tylerreckart/lorentz/images/LORENTZ_REV-A_black.png

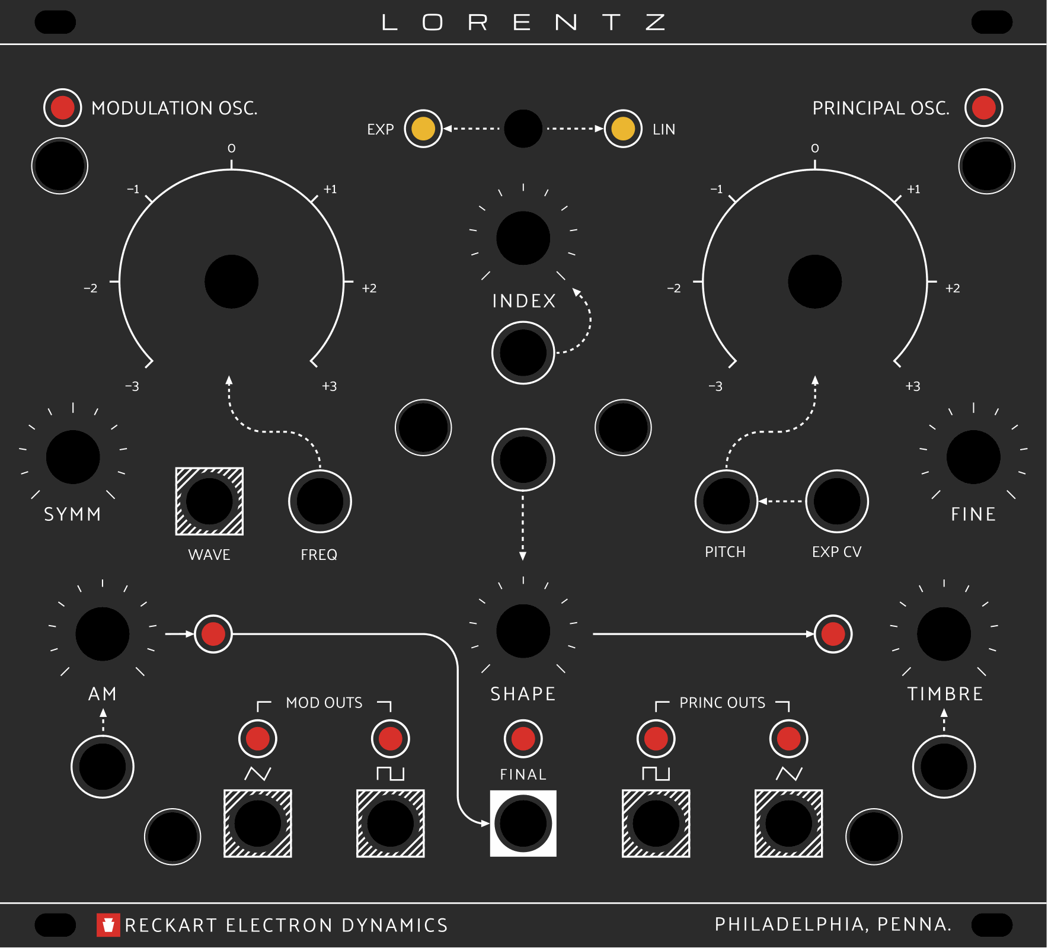
images/LORENTZ_REV-A_black.png
