tylerreckart/lorentz/images/LORENTZ_REV-A_panels.png

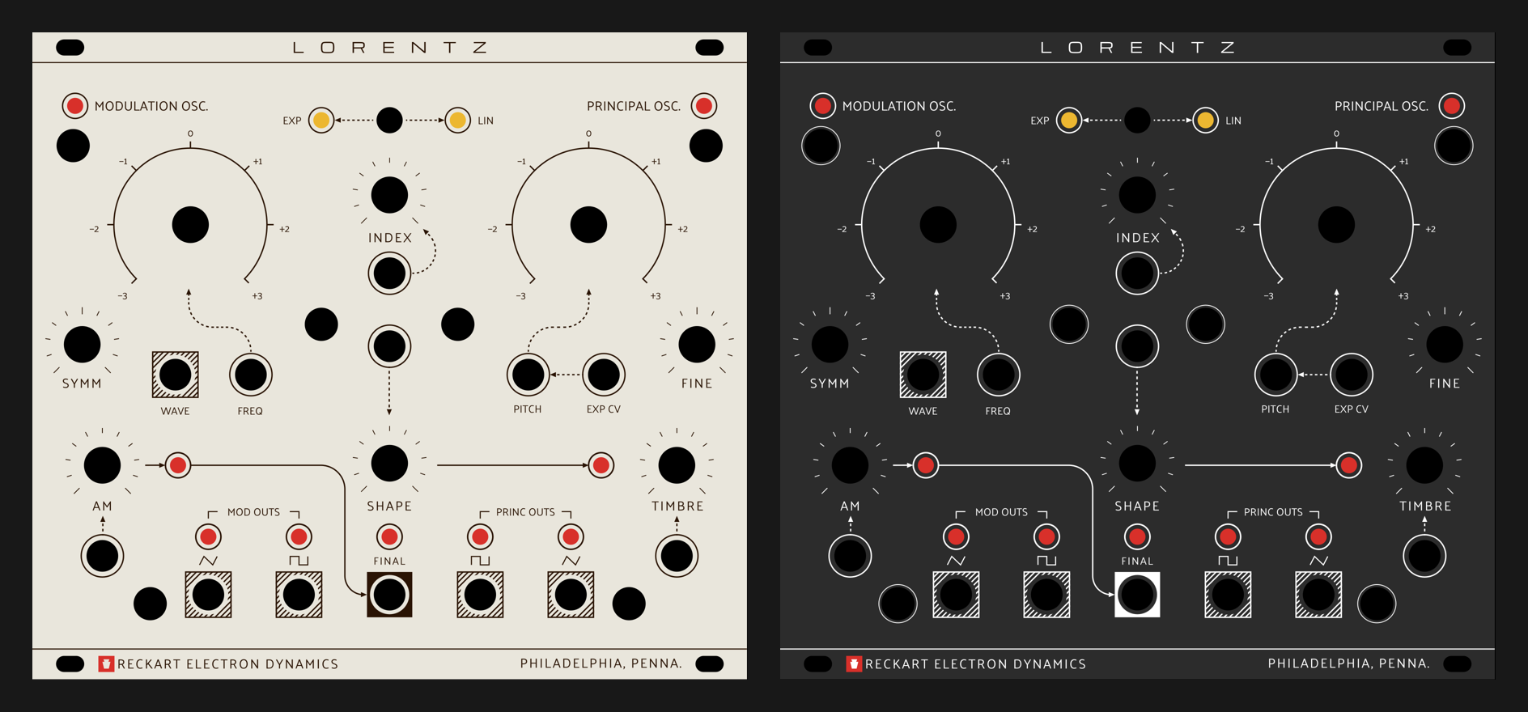
images/LORENTZ_REV-A_panels.png
