tylerreckart/lorentz/bom/LORENTZ_REV-A_BOM.csv

ref | qty | desc | mfr_pn | supplier | supplier_pn | unit_price | ext | stock | URL | need | note
R1,R2 | 10 | Resistor 10 1% 0.25W metal film axial | MFR-25FBF52-10R | Mouser | 603-MFR-25FBF52-10R | 0.1 | 1.0 | stock unverified (site blocks automated access) | https://www.mouser.com/ProductDetail/603-MFR-25FBF52-10R | 2 | 8 spare
R3,R21,R41,R43,R44,R46,R50,R119-R126,R128 | 20 | Resistor 2.2k 1% 0.25W metal film axial | MFR-25FBF52-2K2 | Mouser | 603-MFR-25FBF52-2K2 | 0.06 | 1.2 | stock unverified (site blocks automated access) | https://www.mouser.com/ProductDetail/603-MFR-25FBF52-2K2 | 16 | 4 spare
R4 | 10 | Resistor 187k 1% 0.25W metal film axial | MFR-25FBF52-187K | Mouser | 603-MFR-25FBF52-187K | 0.1 | 1.0 | stock unverified (site blocks automated access) | https://www.mouser.com/ProductDetail/603-MFR-25FBF52-187K | 1 | 9 spare
R26 | 10 | Resistor 442k 1% 0.25W metal film axial | MFR-25FBF52-442K | Mouser | 603-MFR-25FBF52-442K | 0.1 | 1.0 | stock unverified (site blocks automated access) | https://www.mouser.com/ProductDetail/603-MFR-25FBF52-442K | 1 | 9 spare
R5,R31,R32 | 10 | Resistor 110k 1% 0.25W metal film axial | MFR-25FBF52-110K | Mouser | 603-MFR-25FBF52-110K | 0.1 | 1.0 | stock unverified (site blocks automated access) | https://www.mouser.com/ProductDetail/603-MFR-25FBF52-110K | 3 | 7 spare
R7,R34 | 10 | Resistor 47 1% 0.25W metal film axial | MFR-25FBF52-47R | Mouser | 603-MFR-25FBF52-47R | 0.1 | 1.0 | stock unverified (site blocks automated access) | https://www.mouser.com/ProductDetail/603-MFR-25FBF52-47R | 2 | 8 spare
R8 | 10 | Resistor 3.92M 1% 0.25W metal film axial | MFR-25FBF52-3M92 | Mouser | 603-MFR-25FBF52-3M92 | 0.1 | 1.0 | stock unverified (site blocks automated access) | https://www.mouser.com/ProductDetail/603-MFR-25FBF52-3M92 | 1 | 9 spare
R35 | 10 | Resistor 1.5M 1% 0.25W metal film axial | MFR-25FBF52-1M5 | Mouser | 603-MFR-25FBF52-1M5 | 0.1 | 1.0 | stock unverified (site blocks automated access) | https://www.mouser.com/ProductDetail/603-MFR-25FBF52-1M5 | 1 | 9 spare
R9,R36 | 10 | Resistor 6.8k 1% 0.25W metal film axial | MFR-25FBF52-6K8 | Mouser | 603-MFR-25FBF52-6K8 | 0.1 | 1.0 | stock unverified (site blocks automated access) | https://www.mouser.com/ProductDetail/603-MFR-25FBF52-6K8 | 2 | 8 spare
R10 | 10 | Resistor 4.7M 1% 0.25W metal film axial | MFR-25FBF52-4M7 | Mouser | 603-MFR-25FBF52-4M7 | 0.1 | 1.0 | stock unverified (site blocks automated access) | https://www.mouser.com/ProductDetail/603-MFR-25FBF52-4M7 | 1 | 9 spare
R23,R38,R52,R55-R57,R59,R61-R63,R72,R84,R88-R93,R101,R105,R107,R114 | 30 | Resistor 10k 1% 0.25W metal film axial | MFR-25FBF52-10K | Mouser | 603-MFR-25FBF52-10K | 0.06 | 1.8 | stock unverified (site blocks automated access) | https://www.mouser.com/ProductDetail/603-MFR-25FBF52-10K | 22 | 8 spare
R12,R13,R67,R68,R78,R79,R95,R96,R110,R111 | 10 | Resistor 220 1% 0.25W metal film axial | MFR-25FBF52-220R | Mouser | 603-MFR-25FBF52-220R | 0.1 | 1.0 | stock unverified (site blocks automated access) | https://www.mouser.com/ProductDetail/603-MFR-25FBF52-220R | 10
R14,R129,R130 | 10 | Resistor 4.7k 1% 0.25W metal film axial | MFR-25FBF52-4K7 | Mouser | 603-MFR-25FBF52-4K7 | 0.1 | 1.0 | stock unverified (site blocks automated access) | https://www.mouser.com/ProductDetail/603-MFR-25FBF52-4K7 | 3 | 7 spare
R15,R17,R24,R25,R45,R47,R64,R65,R104,R118 | 10 | Resistor 1k 1% 0.25W metal film axial | MFR-25FBF52-1K | Mouser | 603-MFR-25FBF52-1K | 0.1 | 1.0 | stock unverified (site blocks automated access) | https://www.mouser.com/ProductDetail/603-MFR-25FBF52-1K | 10
R16,R18 | 10 | Resistor 470 1% 0.25W metal film axial | MFR-25FBF52-470R | Mouser | 603-MFR-25FBF52-470R | 0.1 | 1.0 | stock unverified (site blocks automated access) | https://www.mouser.com/ProductDetail/603-MFR-25FBF52-470R | 2 | 8 spare
R19,R48 | 10 | Resistor 47k 1% 0.25W metal film axial | MFR-25FBF52-47K | Mouser | 603-MFR-25FBF52-47K | 0.1 | 1.0 | stock unverified (site blocks automated access) | https://www.mouser.com/ProductDetail/603-MFR-25FBF52-47K | 2 | 8 spare
R20,R74,R103 | 10 | Resistor 30k 1% 0.25W metal film axial | MFR-25FBF52-30K | Mouser | 603-MFR-25FBF52-30K | 0.1 | 1.0 | stock unverified (site blocks automated access) | https://www.mouser.com/ProductDetail/603-MFR-25FBF52-30K | 3 | 7 spare
R22,R60 | 10 | Resistor 5.1k 1% 0.25W metal film axial | MFR-25FBF52-5K1 | Mouser | 603-MFR-25FBF52-5K1 | 0.1 | 1.0 | stock unverified (site blocks automated access) | https://www.mouser.com/ProductDetail/603-MFR-25FBF52-5K1 | 2 | 8 spare
R27,R28 | 10 | Resistor 220k 1% 0.25W metal film axial | MFR-25FBF52-220K | Mouser | 603-MFR-25FBF52-220K | 0.1 | 1.0 | stock unverified (site blocks automated access) | https://www.mouser.com/ProductDetail/603-MFR-25FBF52-220K | 2 | 8 spare
R29 | 10 | Resistor 3.3M 1% 0.25W metal film axial | MFR-25FBF52-3M3 | Mouser | 603-MFR-25FBF52-3M3 | 0.1 | 1.0 | stock unverified (site blocks automated access) | https://www.mouser.com/ProductDetail/603-MFR-25FBF52-3M3 | 1 | 9 spare
R30,R71,R73,R75,R76,R83,R85,R94,R98,R100,R102,R109,R113,R115,R117,R131 | 20 | Resistor 100k 1% 0.25W metal film axial | MFR-25FBF52-100K | Mouser | 603-MFR-25FBF52-100K | 0.06 | 1.2 | stock unverified (site blocks automated access) | https://www.mouser.com/ProductDetail/603-MFR-25FBF52-100K | 16 | 4 spare
R106,R108 | 10 | Resistor 4.99k 1% 0.25W metal film axial | MFR-25FBF52-4K99 | Mouser | 603-MFR-25FBF52-4K99 | 0.1 | 1.0 | stock unverified (site blocks automated access) | https://www.mouser.com/ProductDetail/603-MFR-25FBF52-4K99 | 2 | 8 spare
R132 | 10 | Resistor 42.2k 1% 0.25W metal film axial | MFR-25FBF52-42K2 | Mouser | 603-MFR-25FBF52-42K2 | 0.1 | 1.0 | stock unverified (site blocks automated access) | https://www.mouser.com/ProductDetail/603-MFR-25FBF52-42K2 | 1 | 9 spare
R37 | 10 | Resistor 1M 1% 0.25W metal film axial | MFR-25FBF52-1M | Mouser | 603-MFR-25FBF52-1M | 0.1 | 1.0 | stock unverified (site blocks automated access) | https://www.mouser.com/ProductDetail/603-MFR-25FBF52-1M | 1 | 9 spare
R39 | 10 | Resistor 22k 1% 0.25W metal film axial | MFR-25FBF52-22K | Mouser | 603-MFR-25FBF52-22K | 0.1 | 1.0 | stock unverified (site blocks automated access) | https://www.mouser.com/ProductDetail/603-MFR-25FBF52-22K | 1 | 9 spare
R40,R42 | 10 | Resistor 18k 1% 0.25W metal film axial | MFR-25FBF52-18K | Mouser | 603-MFR-25FBF52-18K | 0.1 | 1.0 | stock unverified (site blocks automated access) | https://www.mouser.com/ProductDetail/603-MFR-25FBF52-18K | 2 | 8 spare
R49,R66,R77 | 10 | Resistor 68k 1% 0.25W metal film axial | MFR-25FBF52-68K | Mouser | 603-MFR-25FBF52-68K | 0.1 | 1.0 | stock unverified (site blocks automated access) | https://www.mouser.com/ProductDetail/603-MFR-25FBF52-68K | 3 | 7 spare
R51 | 10 | Resistor 4.3k 1% 0.25W metal film axial | MFR-25FBF52-4K3 | Mouser | 603-MFR-25FBF52-4K3 | 0.1 | 1.0 | stock unverified (site blocks automated access) | https://www.mouser.com/ProductDetail/603-MFR-25FBF52-4K3 | 1 | 9 spare
R53 | 10 | Resistor 91k 1% 0.25W metal film axial | MFR-25FBF52-91K | Mouser | 603-MFR-25FBF52-91K | 0.1 | 1.0 | stock unverified (site blocks automated access) | https://www.mouser.com/ProductDetail/603-MFR-25FBF52-91K | 1 | 9 spare
R54 | 10 | Resistor 39k 1% 0.25W metal film axial | MFR-25FBF52-39K | Mouser | 603-MFR-25FBF52-39K | 0.1 | 1.0 | stock unverified (site blocks automated access) | https://www.mouser.com/ProductDetail/603-MFR-25FBF52-39K | 1 | 9 spare
R58 | 10 | Resistor 20k 1% 0.25W metal film axial | MFR-25FBF52-20K | Mouser | 603-MFR-25FBF52-20K | 0.1 | 1.0 | stock unverified (site blocks automated access) | https://www.mouser.com/ProductDetail/603-MFR-25FBF52-20K | 1 | 9 spare
R69,R80,R99 | 10 | Resistor 200k 1% 0.25W metal film axial | MFR-25FBF52-200K | Mouser | 603-MFR-25FBF52-200K | 0.1 | 1.0 | stock unverified (site blocks automated access) | https://www.mouser.com/ProductDetail/603-MFR-25FBF52-200K | 3 | 7 spare
R70,R81 | 10 | Resistor 330k 1% 0.25W metal film axial | MFR-25FBF52-330K | Mouser | 603-MFR-25FBF52-330K | 0.1 | 1.0 | stock unverified (site blocks automated access) | https://www.mouser.com/ProductDetail/603-MFR-25FBF52-330K | 2 | 8 spare
R82 | 10 | Resistor 680k 1% 0.25W metal film axial | MFR-25FBF52-680K | Mouser | 603-MFR-25FBF52-680K | 0.1 | 1.0 | stock unverified (site blocks automated access) | https://www.mouser.com/ProductDetail/603-MFR-25FBF52-680K | 1 | 9 spare
R86,R133 | 10 | Resistor 470k 1% 0.25W metal film axial | MFR-25FBF52-470K | Mouser | 603-MFR-25FBF52-470K | 0.1 | 1.0 | stock unverified (site blocks automated access) | https://www.mouser.com/ProductDetail/603-MFR-25FBF52-470K | 2 | 8 spare
R87 | 10 | Resistor 25.5k 1% 0.25W metal film axial | MFR-25FBF52-25K5 | Mouser | 603-MFR-25FBF52-25K5 | 0.1 | 1.0 | stock unverified (site blocks automated access) | https://www.mouser.com/ProductDetail/603-MFR-25FBF52-25K5 | 1 | 9 spare
R97 | 10 | Resistor 240k 1% 0.25W metal film axial | MFR-25FBF52-240K | Mouser | 603-MFR-25FBF52-240K | 0.1 | 1.0 | stock unverified (site blocks automated access) | https://www.mouser.com/ProductDetail/603-MFR-25FBF52-240K | 1 | 9 spare
R112 | 10 | Resistor 143k 1% 0.25W metal film axial | MFR-25FBF52-143K | Mouser | 603-MFR-25FBF52-143K | 0.1 | 1.0 | stock unverified (site blocks automated access) | https://www.mouser.com/ProductDetail/603-MFR-25FBF52-143K | 1 | 9 spare
R116 | 10 | Resistor 34k 1% 0.25W metal film axial | MFR-25FBF52-34K | Mouser | 603-MFR-25FBF52-34K | 0.1 | 1.0 | stock unverified (site blocks automated access) | https://www.mouser.com/ProductDetail/603-MFR-25FBF52-34K | 1 | 9 spare
C3,C4,C6-C13,C17-C20,C23,C24,C26-C31,C36-C39,C44-C49 | 40 | 100nF X7R 50V 2.54mm | C320C104K5R5TA | Mouser | 80-C320C104K5R | 0.15 | 6.0 | stock unverified (site blocks automated access) | https://www.mouser.com/ProductDetail/80-C320C104K5R | 32 | 8 spare
C1,C2 | 5 | 47uF 25V electrolytic 5mm | EEU-FR1E470 | Mouser | 667-EEU-FR1E470 | 0.35 | 1.75 | stock unverified (site blocks automated access) | https://www.mouser.com/ProductDetail/667-EEU-FR1E470 | 2 | 3 spare
C5 | 5 | 10uF 25V electrolytic 5mm | EEU-FR1E100 | Mouser | 667-EEU-FR1E100 | 0.3 | 1.5 | stock unverified (site blocks automated access) | https://www.mouser.com/ProductDetail/667-EEU-FR1E100 | 1 | 4 spare
C14,C21,C33,C35,C41,C43 | 10 | 47pF C0G 100V | C315C470J1G5TA | Mouser | 80-C315C470J1G5TA | 0.3 | 3.0 | stock unverified (site blocks automated access) | https://www.mouser.com/ProductDetail/80-C315C470J1G5TA | 6 | 4 spare
C15,C22,C32,C34,C40,C42 | 10 | 100pF C0G 100V | C315C101J1G5TA | Mouser | 80-C315C101J1G5TA | 0.3 | 3.0 | stock unverified (site blocks automated access) | https://www.mouser.com/ProductDetail/80-C315C101J1G5TA | 6 | 4 spare
C16 | 2 | 10nF C0G 5% 50V 2.5mm (mod osc timing) | FG18C0G1H103JNT06 | Mouser | 810-FG18C0G1H103JNT6 | 0.38 | 0.76 | stock unverified; price = $0.38 qty-1 DigiKey-catalog figure (DigiKey 5802786, via chipsfind.com mirror 2026-11-01; Mouser/DigiKey pages block automated access); LCSC $0.39@5+ | https://www.mouser.com/ProductDetail/810-FG18C0G1H103JNT6 | 1 | 1 spare
C25 | 2 | 330pF C0G 1% | C315C331F1G5TA | Mouser | 80-C315C331F1G5TA | 0.8 | 1.6 | stock unverified (site blocks automated access) | https://www.mouser.com/ProductDetail/80-C315C331F1G5TA | 1 | 1 spare
D1,D2 | 5 | 1N5817 Schottky (reverse-polarity) | 1N5817G | Mouser | 863-1N5817G | 0.3 | 1.5 | stock unverified (site blocks automated access) | https://www.mouser.com/ProductDetail/863-1N5817G | 2 | 3 spare
D3 | 5 | BZX79-C5V1 zener 5.1V | BZX79-C5V1,133 | Mouser | 771-BZX79-C5V1-T/R | 0.1 | 0.5 | stock unverified (site blocks automated access) | https://www.mouser.com/ProductDetail/771-BZX79-C5V1-T/R | 1 | 4 spare
D45 | 5 | BZX79-B6V8 zener 6.8V 2% (SHAPE CV clamp) | BZX79-B6V8,133 | Mouser | 771-BZX79-B6V8-T/R | 0.1 | 0.5 | stock unverified (site blocks automated access); price est. | https://www.mouser.com/c/?q=BZX79-B6V8 | 1 | 4 spare
D4-D22,D24,D26,D28,D30,D32,D34,D36,D38,D42 | 30 | 1N4148 | 1N4148 | Mouser | 512-1N4148 | 0.1 | 3.0 | stock unverified (site blocks automated access) | https://www.mouser.com/ProductDetail/512-1N4148 | 28 | 2 spare
Q1-Q4 | 10 | BC557B PNP | BC557BTA | Mouser | 512-BC557BTA | 0.1 | 1.0 | stock unverified (site blocks automated access) | https://www.mouser.com/ProductDetail/512-BC557BTA | 4 | 6 spare
J1 | 1 | 2x5 shrouded Eurorack power header | 61201021621 | Mouser | 710-61201021621 | 0.45 | 0.45 | stock unverified (site blocks automated access) | https://www.mouser.com/ProductDetail/710-61201021621 | 1
J20,J21 (circuit) | 2 | 2x15 female socket 2.54 (board-to-board) | SSW-115-01-T-D | Mouser | 200-SSW11501TD | 3.6 | 7.2 | stock unverified (site blocks automated access) | https://www.mouser.com/ProductDetail/200-SSW11501TD | 2
J20,J21 (control) | 2 | 2x15 male header 2.54 (board-to-board) | TSW-115-07-T-D | Mouser | 200-TSW11507TD | 1.9 | 3.8 | stock unverified (site blocks automated access) | https://www.mouser.com/ProductDetail/200-TSW11507TD | 2
RV4 | 1 | Trimmer 20k 3296W | 3296W-1-203LF | Mouser | 652-3296W-1-203LF | 2.6 | 2.6 | stock unverified (site blocks automated access) | https://www.mouser.com/ProductDetail/652-3296W-1-203LF | 1
RV5 | 1 | Trimmer 10k 3296W | 3296W-1-103LF | Mouser | 652-3296W-1-103LF | 2.6 | 2.6 | stock unverified (site blocks automated access) | https://www.mouser.com/ProductDetail/652-3296W-1-103LF | 1
RV11 | 1 | Trimmer 100k 3296W (SHAPE VCA offset null) | 3296W-1-104LF | Mouser | 652-3296W-1-104LF | 2.6 | 2.6 | stock unverified (site blocks automated access); price est. (same as RV4/RV5) | https://www.mouser.com/ProductDetail/652-3296W-1-104LF | 1
U4,U6 | 2 | CD4053BE | CD4053BE | Mouser | 595-CD4053BE | 0.89 | 1.78 | 707 (indexed, unverified live) | https://www.mouser.com/ProductDetail/595-CD4053BE | 2
U5,U7-U9,U11,U12,U14-U16 | 10 | TL074CN quad op-amp | TL074CN | Mouser | 595-TL074CN | 0.84 | 8.4 | ~4048 (indexed, unverified live) | https://www.mouser.com/ProductDetail/595-TL074CN | 9 | 1 spare
D23,D25,D27,D29,D31,D33,D35,D37,D41 | 10 | 3mm red LED | WP710A10ID | Mouser | 604-WP710A10ID | 0.3 | 3.0 | stock unverified (site blocks automated access) | https://www.mouser.com/ProductDetail/604-WP710A10ID | 9 | 1 spare
D43,D44 | 3 | 3mm amber LED (EXP/LIN) | WP710A10ND | Mouser | 604-WP710A10ND | 0.3 | 0.9 | stock unverified (site blocks automated access) | https://www.mouser.com/ProductDetail/604-WP710A10ND | 2 | 1 spare
DIP-14 sockets | 11 | DIP-14 socket | 1-2199298-3 | Mouser | 571-1-2199298-3 | 0.25 | 2.75 | stock unverified (site blocks automated access) | https://www.mouser.com/ProductDetail/571-1-2199298-3 | 11
DIP-16 sockets | 5 | DIP-16 socket | 1-2199298-4 | Mouser | 571-1-2199298-4 | 0.28 | 1.4 | stock unverified (site blocks automated access) | https://www.mouser.com/ProductDetail/571-1-2199298-4 | 5
H (panel-control) | 6 | M3x10 F-F hex standoff | 970100365 | Mouser | 710-970100365 | 0.55 | 3.3 | stock unverified (site blocks automated access) | https://www.mouser.com/ProductDetail/710-970100365 | 6
H (control-circuit) | 6 | M3x11 M-F hex standoff (length: verify) | 971110365 | Mouser | 710-971110365 | 0.6 | 3.6 | stock unverified (site blocks automated access) | https://www.mouser.com/ProductDetail/710-971110365 | 6
U2 | 1 | LM319N dual comparator DIP-14 (genuine TI) | LM319N/NOPB | TME | LM319N/NOPB | 1.16 | 1.16 | 229 (via oemsecrets, est.) | https://www.tme.com/us/en-us/details/lm319n_nopb/tht-comparators/texas-instruments/ | 1 | DROP-IN. Backup: Electrokit LM319N 63 pcs 18.50 SEK
U3,U10,U13 | 3 | LM13700N DIP-16 OTA (genuine TI) | LM13700N/NOPB | Jameco | 2308167 | 2.25 | 6.75 | 380 (live) | https://www.jameco.com/z/LM13700N-NOPB-TI-Transconductance-Amplifier-Dual-Circuit-Push-Pull-PDIP-16_2308167.html | 3 | DROP-IN. Backup: Electrokit 4103 (HGSEMI clone) 420 pcs 9.50 SEK
U1 | 1 | THAT320 quad matched PNP DIP-14 (expo) | THAT320P14-U | Newark | 50M5198 | 9.92 | 9.92 | 13 (live) | https://www.newark.com/that-corporation/that320p14-u/transistor-array-dip14-320/dp/50M5198 | 1 | DROP-IN; EOL, buy now. Backup: THAT320S14-U SO-14 (Newark 50M5199, 36 @ $9.24) + SOIC14-DIP14 adapter
U1 backup adapter | 0 | (optional) SOIC-14 to DIP-14 adapter, only if SO-14 backup used |  | any (hardware) |  | 0 | 0 |  |  | 0 | not in total
J2-J14 | 13 | Thonkiconn 3.5mm jack (PJ398SM) | WQP518MA | Thonk | Thonkiconn | 0.505 | 6.57 | In stock (live) | https://www.thonk.co.uk/shop/thonkiconn/ | 13
RV1,RV2 | 2 | Alpha 16mm B10K PCB, 6.35mm round shaft | RV16AF-41-15R1-B10K | Modtek (UK) | p_137 | 1.862 | 3.72 | 40 in stock (live; confirm 6.35mm/B10K option) | https://www.modtek.uk/16mm-Taiwan-Alpha-RV16AF-Potentiometer-with-PCB-Pins-6mm-or-635mm-Round-Shaft-15mm-Shaft-Length_p_137.html | 2 | Tayda A-2969 OOS; x5 BOM '-10' PN was wrong, footprint=-41
RV3,RV6-RV10 | 6 | Alpha 9mm vertical B100K round shaft | RD901F-40-15R1-B100K | Thonk | Alpha 9mm B100K | 2.248 | 13.49 | In stock (live) | https://www.thonk.co.uk/shop/alpha-9mm-pots/ | 6
R6,R33 | 2 | 2k tempco +3300ppm 1% 1/6W axial | Linear PTC 2k 3300ppm | Sonic Synths (UK) | 3801-186 | 1.835 | 3.67 | In stock (live) | https://sonicsynths.com/products/linear_ptc_2k_1-_3300ppm_1-6w_tempco_resistor | 2 | DROP-IN (matches design). Backup: SAMODULAR Akaneohm 2K 3300ppm EUR1.60
SW1 | 1 | Dailywell sub-mini DPDT ON-ON toggle, 10-48 bushing; panel hole 5.2 mm , single outer nut | 2MD1T1B1M2QES | Mouser | 118-2MD1T1B1M2QES | 5.25 | 5.25 | 205 (Mouser UK listing, est.; GBP3.95) | https://www.mouser.com/ProductDetail/118-2MD1T1B1M2QES | 1 | SAME PCB FOOTPRINT; PANEL H33 6.5->5.2mm. Backup: 2MD1T1B3M2QES (keyway) 309 pcs
Knobs RV1,RV2 | 2 | Davies 1913 skirted knob | 1913 | Amplified Parts | P-K234 | 2.05 | 4.1 | In stock (live) | https://www.amplifiedparts.com/products/knob-davies-1910-and-1913-daka-ware-skirted | 2 | pick black/1913 variant
Knobs small | 6 | 1900h-style knob black, 6.35mm round | 1900h | Thonk | 1900h black | 1.729 | 10.37 | In stock (live) | https://www.thonk.co.uk/shop/1900h-knobs/ | 6 | SUBSTITUTE: 3x Davies 1510 clone (Tayda A-398 OOS) replaced by 1900h; all 6 small knobs 1900h
Power | 1 | Eurorack 10-to-16 pin ribbon cable |  | Thonk | Eurorack power cable | 1.995 | 2.0 | unverified | https://www.thonk.co.uk/ | 1 | est.
H nuts | 6 | M3 hex nut A2 | ISO 4032 M3 | any (hardware) |  | 0.05 | 0.3 | generic |  | 10 | 4 spare
H panel screws | 6 | M3x6 countersunk DIN 965 black | DIN 965 M3x6 black | any (hardware) |  | 0.1 | 0.6 | generic |  | 10 | source black A2 pack (Amazon/McMaster); 4 spare
