tylerreckart/lorentz/bom/VCO_CIRCUIT_bom_from_sch.csv

Refs | Value | Footprint | Qty | DNP
C1 | 47u | Capacitor_THT:CP_Radial_D5.0mm_P2.00mm | 1
C2 | 47u | Capacitor_THT:CP_Radial_D5.0mm_P2.00mm | 1
C3 | 100n | Capacitor_THT:C_Disc_D3.0mm_W2.0mm_P2.50mm | 1
C4 | 100n | Capacitor_THT:C_Disc_D3.0mm_W2.0mm_P2.50mm | 1
C5 | 10u | Capacitor_THT:CP_Radial_D5.0mm_P2.00mm | 1
C6 | 100n | Capacitor_THT:C_Disc_D3.0mm_W2.0mm_P2.50mm | 1
C7 | 100n | Capacitor_THT:C_Disc_D3.0mm_W2.0mm_P2.50mm | 1
C8 | 100n | Capacitor_THT:C_Disc_D3.0mm_W2.0mm_P2.50mm | 1
C9 | 100n | Capacitor_THT:C_Disc_D3.0mm_W2.0mm_P2.50mm | 1
C10 | 100n | Capacitor_THT:C_Disc_D3.0mm_W2.0mm_P2.50mm | 1
C11 | 100n | Capacitor_THT:C_Disc_D3.0mm_W2.0mm_P2.50mm | 1
C12 | 100n | Capacitor_THT:C_Disc_D3.0mm_W2.0mm_P2.50mm | 1
C13 | 100n | Capacitor_THT:C_Disc_D3.0mm_W2.0mm_P2.50mm | 1
C14 | 47p | Capacitor_THT:C_Disc_D3.0mm_W2.0mm_P2.50mm | 1
C15 | 100p | Capacitor_THT:C_Disc_D3.0mm_W2.0mm_P2.50mm | 1
C16 | 10n C0G | Capacitor_THT:C_Disc_D3.0mm_W2.0mm_P2.50mm | 1
C17 | 100n | Capacitor_THT:C_Disc_D3.0mm_W2.0mm_P2.50mm | 1
C18 | 100n | Capacitor_THT:C_Disc_D3.0mm_W2.0mm_P2.50mm | 1
C19 | 100n | Capacitor_THT:C_Disc_D3.0mm_W2.0mm_P2.50mm | 1
C20 | 100n | Capacitor_THT:C_Disc_D3.0mm_W2.0mm_P2.50mm | 1
C21 | 47p | Capacitor_THT:C_Disc_D3.0mm_W2.0mm_P2.50mm | 1
C22 | 100p | Capacitor_THT:C_Disc_D3.0mm_W2.0mm_P2.50mm | 1
C23 | 100n | Capacitor_THT:C_Disc_D3.0mm_W2.0mm_P2.50mm | 1
C24 | 100n | Capacitor_THT:C_Disc_D3.0mm_W2.0mm_P2.50mm | 1
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
R119 | 2.2k | Resistor_THT:R_Axial_DIN0204_L3.6mm_D1.6mm_P2.54mm_Vertical | 1
R120 | 2.2k | Resistor_THT:R_Axial_DIN0204_L3.6mm_D1.6mm_P2.54mm_Vertical | 1
R121 | 2.2k | Resistor_THT:R_Axial_DIN0204_L3.6mm_D1.6mm_P2.54mm_Vertical | 1
R122 | 2.2k | Resistor_THT:R_Axial_DIN0204_L3.6mm_D1.6mm_P2.54mm_Vertical | 1
R123 | 2.2k | Resistor_THT:R_Axial_DIN0204_L3.6mm_D1.6mm_P2.54mm_Vertical | 1
R124 | 2.2k | Resistor_THT:R_Axial_DIN0204_L3.6mm_D1.6mm_P2.54mm_Vertical | 1
R125 | 2.2k | Resistor_THT:R_Axial_DIN0204_L3.6mm_D1.6mm_P2.54mm_Vertical | 1
R126 | 2.2k | Resistor_THT:R_Axial_DIN0204_L3.6mm_D1.6mm_P2.54mm_Vertical | 1
R128 | 2.2k | Resistor_THT:R_Axial_DIN0204_L3.6mm_D1.6mm_P2.54mm_Vertical | 1
R129 | 4.7k | Resistor_THT:R_Axial_DIN0204_L3.6mm_D1.6mm_P2.54mm_Vertical | 1
R130 | 4.7k | Resistor_THT:R_Axial_DIN0204_L3.6mm_D1.6mm_P2.54mm_Vertical | 1
R131 | 100k | Resistor_THT:R_Axial_DIN0204_L3.6mm_D1.6mm_P2.54mm_Vertical | 1
R132 | 42.2k | Resistor_THT:R_Axial_DIN0204_L3.6mm_D1.6mm_P2.54mm_Vertical | 1
R133 | 470k | Resistor_THT:R_Axial_DIN0204_L3.6mm_D1.6mm_P2.54mm_Vertical | 1
RV4 | 20k | Potentiometer_THT:Potentiometer_Bourns_3296W_Vertical | 1
RV5 | 10k | Potentiometer_THT:Potentiometer_Bourns_3296W_Vertical | 1
RV11 | 100k | Potentiometer_THT:Potentiometer_Bourns_3296W_Vertical | 1
U1 | THAT320P14-U | Package_DIP:DIP-14_W7.62mm_Socket | 1
U2 | LM319N/NOPB | Package_DIP:DIP-14_W7.62mm_Socket | 1
U3 | LM13700N/NOPB | Package_DIP:DIP-16_W7.62mm_Socket | 1
U4 | CD4053BE | Package_DIP:DIP-16_W7.62mm_Socket | 1
U5 | TL074 | Package_DIP:DIP-14_W7.62mm_Socket | 1
U6 | CD4053BE | Package_DIP:DIP-16_W7.62mm_Socket | 1
U7 | TL074 | Package_DIP:DIP-14_W7.62mm_Socket | 1
U8 | TL074 | Package_DIP:DIP-14_W7.62mm_Socket | 1
U9 | TL074 | Package_DIP:DIP-14_W7.62mm_Socket | 1
U10 | LM13700N/NOPB | Package_DIP:DIP-16_W7.62mm_Socket | 1
U11 | TL074 | Package_DIP:DIP-14_W7.62mm_Socket | 1
U12 | TL074 | Package_DIP:DIP-14_W7.62mm_Socket | 1
U13 | LM13700N/NOPB | Package_DIP:DIP-16_W7.62mm_Socket | 1
U14 | TL074 | Package_DIP:DIP-14_W7.62mm_Socket | 1
U15 | TL074 | Package_DIP:DIP-14_W7.62mm_Socket | 1
U16 | TL074 | Package_DIP:DIP-14_W7.62mm_Socket | 1
