tylerreckart/lorentz/bom/VCO_CONTROL_bom_from_sch.csv

Refs | Value | Footprint | Qty | DNP
D23 | 3mm red | LED_THT:LED_D3.0mm | 1
D25 | 3mm red | LED_THT:LED_D3.0mm | 1
D27 | 3mm red | LED_THT:LED_D3.0mm | 1
D29 | 3mm red | LED_THT:LED_D3.0mm | 1
D31 | 3mm red | LED_THT:LED_D3.0mm | 1
D33 | 3mm red | LED_THT:LED_D3.0mm | 1
D35 | 3mm red | LED_THT:LED_D3.0mm | 1
D37 | 3mm red | LED_THT:LED_D3.0mm | 1
D41 | 3mm red | LED_THT:LED_D3.0mm | 1
D43 | 3mm amber | LED_THT:LED_D3.0mm | 1
D44 | 3mm amber | LED_THT:LED_D3.0mm | 1
J2 | PJ398SM | Connector_Audio:Jack_3.5mm_QingPu_WQP-PJ398SM_Vertical_CircularHoles | 1
J3 | PJ398SM | Connector_Audio:Jack_3.5mm_QingPu_WQP-PJ398SM_Vertical_CircularHoles | 1
J4 | PJ398SM | Connector_Audio:Jack_3.5mm_QingPu_WQP-PJ398SM_Vertical_CircularHoles | 1
J5 | PJ398SM | Connector_Audio:Jack_3.5mm_QingPu_WQP-PJ398SM_Vertical_CircularHoles | 1
J6 | PJ398SM | Connector_Audio:Jack_3.5mm_QingPu_WQP-PJ398SM_Vertical_CircularHoles | 1
J7 | PJ398SM | Connector_Audio:Jack_3.5mm_QingPu_WQP-PJ398SM_Vertical_CircularHoles | 1
J8 | PJ398SM | Connector_Audio:Jack_3.5mm_QingPu_WQP-PJ398SM_Vertical_CircularHoles | 1
J9 | PJ398SM | Connector_Audio:Jack_3.5mm_QingPu_WQP-PJ398SM_Vertical_CircularHoles | 1
J10 | PJ398SM | Connector_Audio:Jack_3.5mm_QingPu_WQP-PJ398SM_Vertical_CircularHoles | 1
J11 | PJ398SM | Connector_Audio:Jack_3.5mm_QingPu_WQP-PJ398SM_Vertical_CircularHoles | 1
J12 | PJ398SM | Connector_Audio:Jack_3.5mm_QingPu_WQP-PJ398SM_Vertical_CircularHoles | 1
J13 | PJ398SM | Connector_Audio:Jack_3.5mm_QingPu_WQP-PJ398SM_Vertical_CircularHoles | 1
J14 | PJ398SM | Connector_Audio:Jack_3.5mm_QingPu_WQP-PJ398SM_Vertical_CircularHoles | 1
J20 | B2B 2x15 male | Connector_PinHeader_2.54mm:PinHeader_2x15_P2.54mm_Vertical | 1
J21 | B2B 2x15 male | Connector_PinHeader_2.54mm:PinHeader_2x15_P2.54mm_Vertical | 1
RV1 | 10k | VCO25:Alpha_RV16AF-41_Single_Vertical | 1
RV2 | 10k | VCO25:Alpha_RV16AF-41_Single_Vertical | 1
RV3 | 100k | Potentiometer_THT:Potentiometer_Alpha_RD901F-40-00D_Single_Vertical | 1
RV6 | 100k | Potentiometer_THT:Potentiometer_Alpha_RD901F-40-00D_Single_Vertical | 1
RV7 | 100k | Potentiometer_THT:Potentiometer_Alpha_RD901F-40-00D_Single_Vertical | 1
RV8 | 100k | Potentiometer_THT:Potentiometer_Alpha_RD901F-40-00D_Single_Vertical | 1
RV9 | 100k | Potentiometer_THT:Potentiometer_Alpha_RD901F-40-00D_Single_Vertical | 1
RV10 | 100k | Potentiometer_THT:Potentiometer_Alpha_RD901F-40-00D_Single_Vertical | 1
SW1 | 2MD1T1B1M2QES | VCO:SW_Dailywell_2MD1_M2 | 1
