tylerreckart/lorentz/panel/black/panel_REV-A_cut.dxf

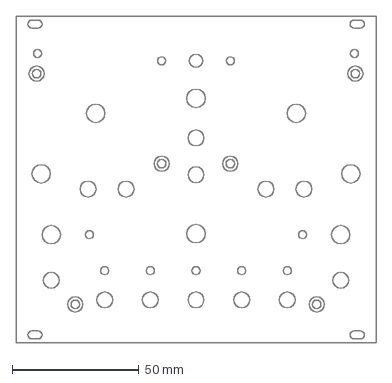
[picture p4: CAD file, 2026-11-01]
panel/black/panel_REV-A_cut.dxf
141.9 x 128.5 mm
