tylerreckart/lorentz/images/manual/block_diagram.png

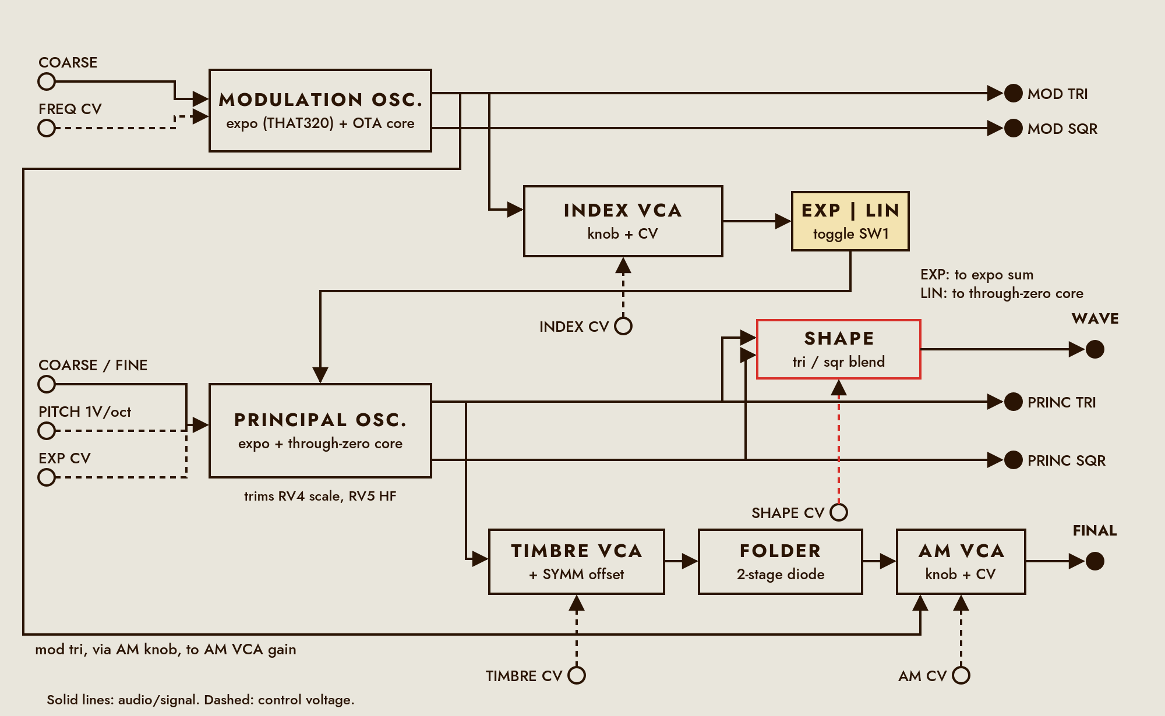
images/manual/block_diagram.png
