tylerreckart/lorentz/circuit_board/VCO_CIRCUIT_schematic.pdf

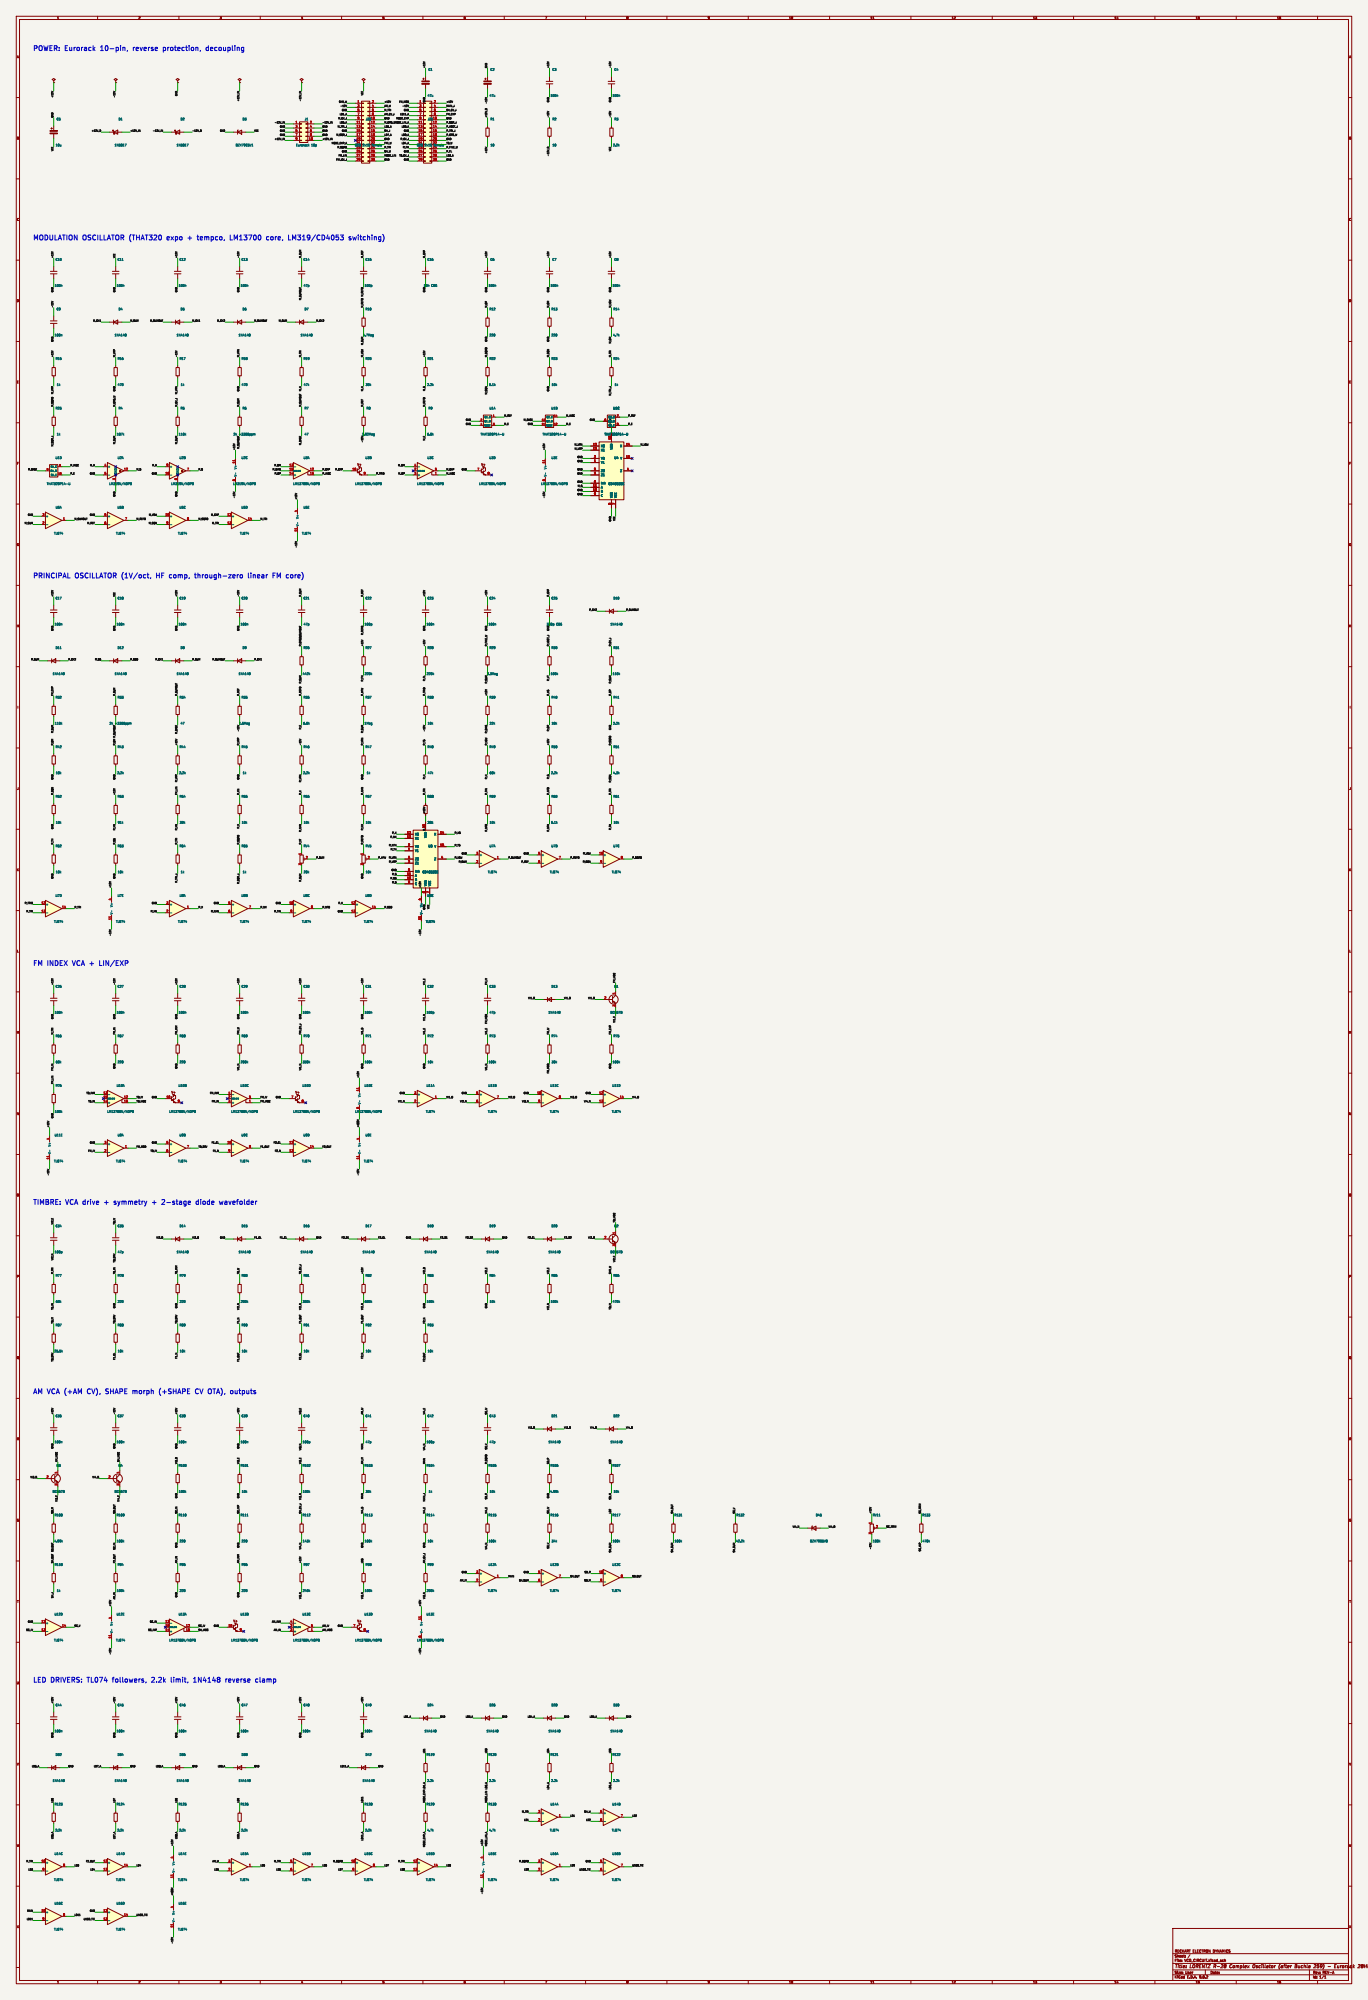
[picture p10: page 1]

GND GND
LM13700N/NOPB R27

GND FM INDEX VCA + LIN/EXP

AM VCA (+AM CV), SHAPE morph (+SHAPE CV OTA), outputs
