tylerreckart/lorentz/control_board/VCO_CONTROL_schematic.pdf

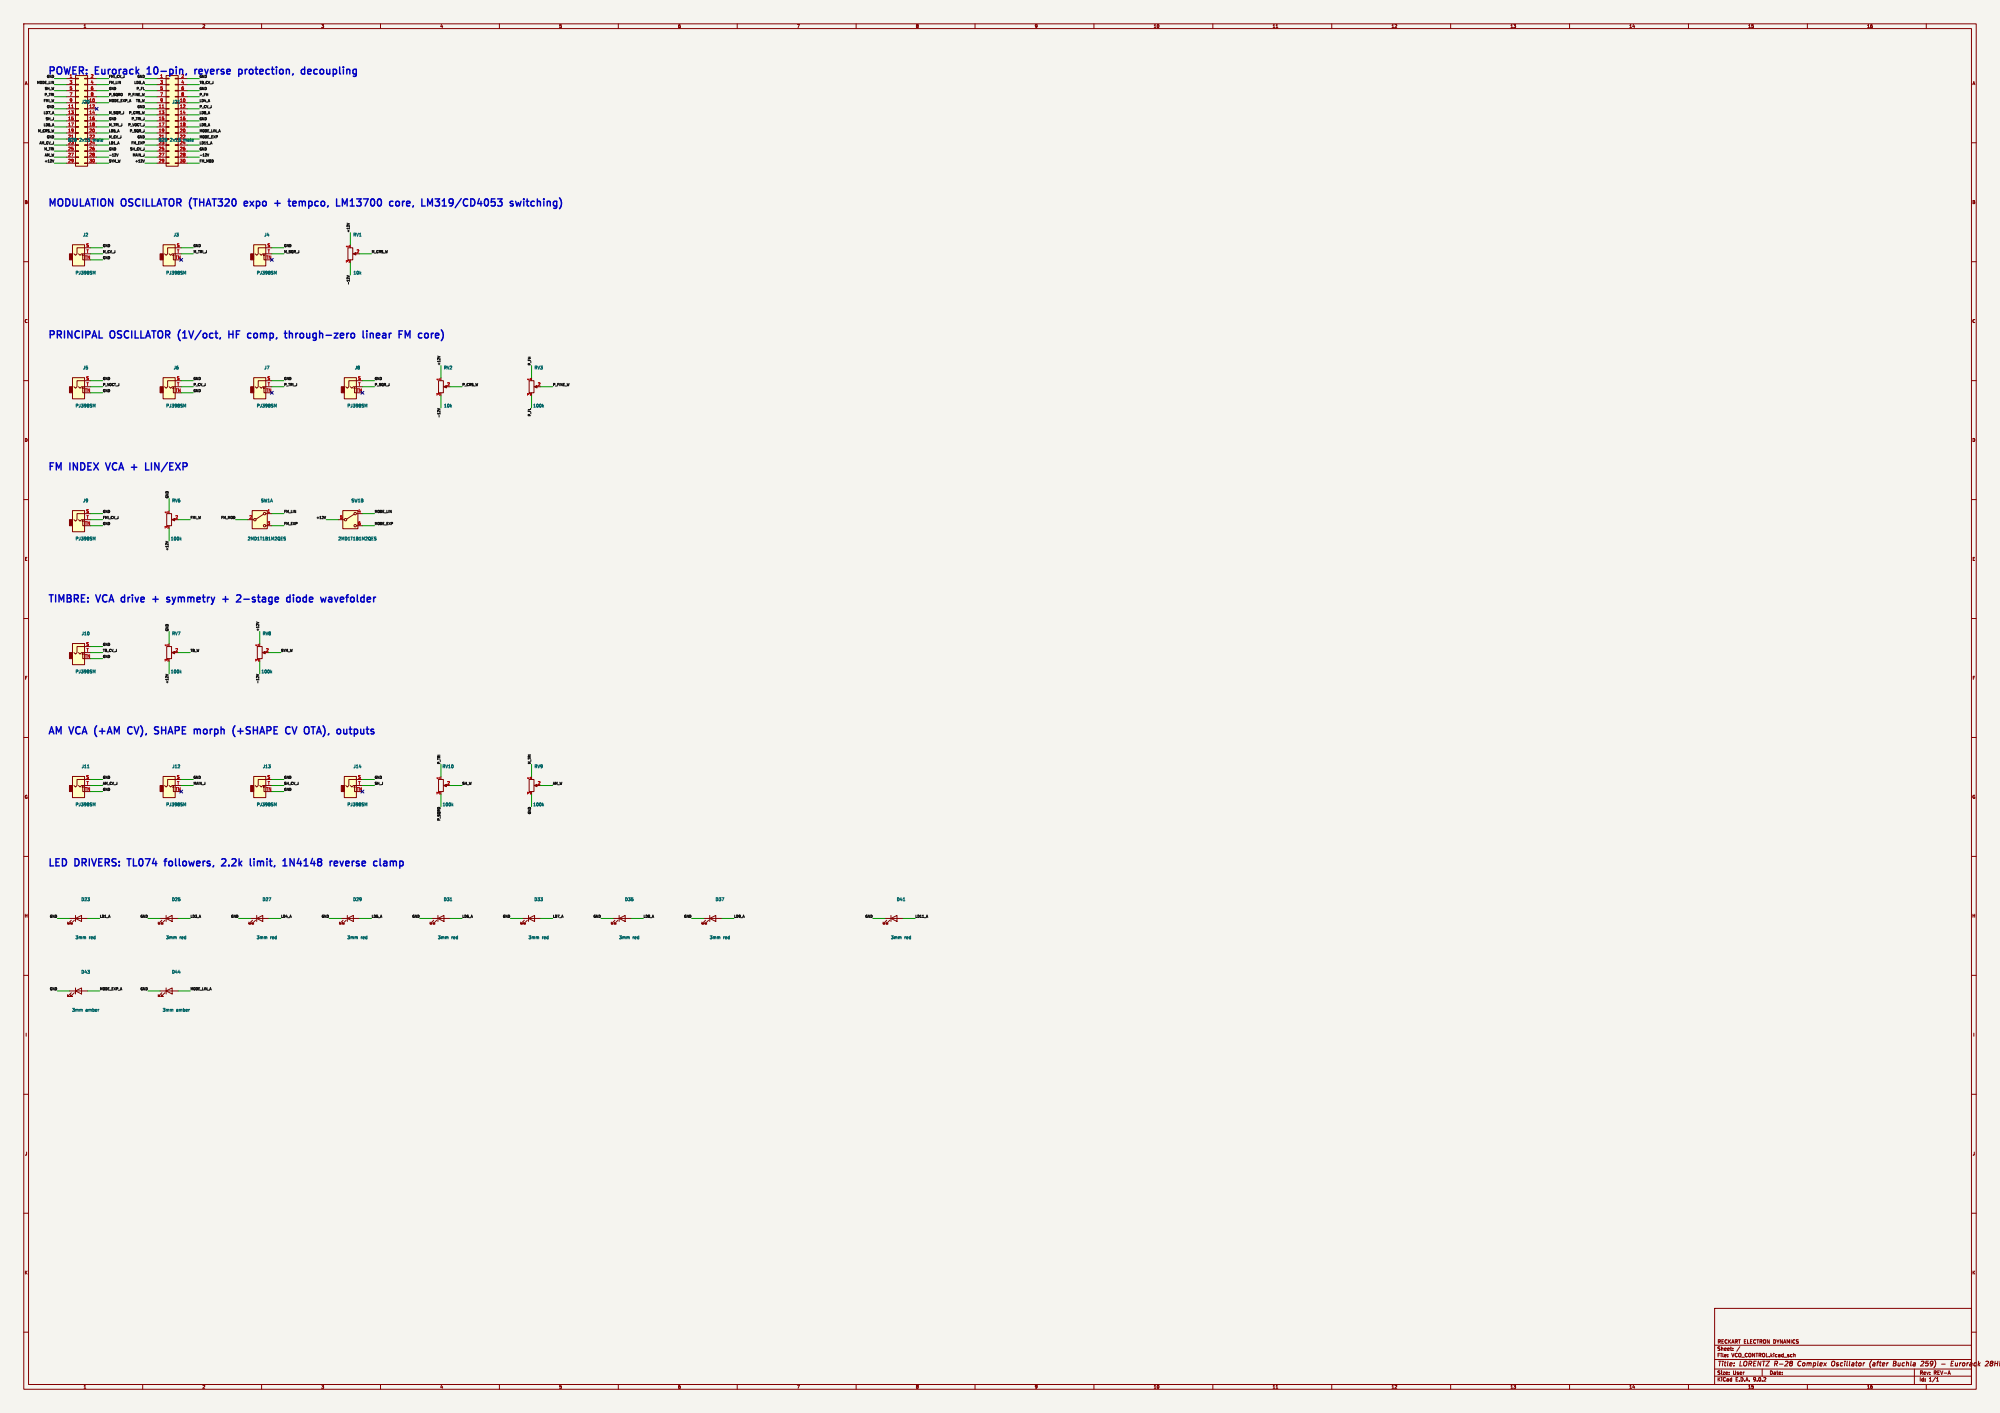
[picture p11: page 1]

FM INDEX VCA + LIN/EXP

AM VCA (+AM CV), SHAPE morph (+SHAPE CV OTA), outputs
