tylerreckart/lorentz/circuit_board/VCO_CIRCUIT.kicad_pcb

## KiCad design circuit_board/VCO_CIRCUIT.kicad_pcb (2026-11-02)

Schematic: VCO_CIRCUIT.kicad_sch, LORENTZ R-28 Complex Oscillator (after Buchla 259) - Eurora…

Parts:
C1, C2: 47u; CP_Radial_D5.0mm_P2.00mm
C3, C4, C6, C7, C8, C9, C10, C11, C12, C13, C17, C18, C19, C20, C23, C24, C26, C27, C28, C29, C30, C31, C36, C37, C38, C39, C44, C45, C46, C47, C48, C49: 100n; C_Disc_D3.0mm_W2.0mm_P2.50mm
C5: 10u; CP_Radial_D5.0mm_P2.00mm
C14, C21, C33, C35, C41, C43: 47p; C_Disc_D3.0mm_W2.0mm_P2.50mm
C15, C22, C32, C34, C40, C42: 100p; C_Disc_D3.0mm_W2.0mm_P2.50mm
C16: 10n C0G; C_Disc_D3.0mm_W2.0mm_P2.50mm
C25: 330p C0G; C_Disc_D3.0mm_W2.0mm_P2.50mm
D1, D2: 1N5817; D_DO-41_SOD81_P10.16mm_Horizontal
D3: BZX79C5V1; D_DO-35_SOD27_P2.54mm_Vertical_KathodeUp
D4, D5, D6, D7, D8, D9, D10, D11, D12, D13, D14, D15, D16, D17, D18, D19, D20, D21, D22, D24, D26, D28, D30, D32, D34, D36, D38, D42: 1N4148; D_DO-35_SOD27_P2.54mm_Vertical_KathodeUp
D45: BZX79B6V8; D_DO-35_SOD27_P2.54mm_Vertical_KathodeUp
J1: Eurorack 10p; IDC-Header_2x05_P2.54mm_Vertical__J1
J20, J21: B2B 2x15 female; PinSocket_2x15_P2.54mm_Vertical
Q1, Q2, Q3, Q4: BC557B; TO-92_Inline
R1, R2: 10; R_Axial_DIN0204_L3.6mm_D1.6mm_P2.54mm_Vertical
R3, R21, R41, R43, R44, R46, R50, R119, R120, R121, R122, R123, R124, R125, R126, R128: 2.2k; R_Axial_DIN0204_L3.6mm_D1.6mm_P2.54mm_Vertical
R4: 187k; R_Axial_DIN0204_L3.6mm_D1.6mm_P2.54mm_Vertical
R5, R31, R32: 110k; R_Axial_DIN0204_L3.6mm_D1.6mm_P2.54mm_Vertical
R6, R33: 2k +3300ppm; R_Axial_DIN0204_L3.6mm_D1.6mm_P2.54mm_Vertical
R7, R34: 47; R_Axial_DIN0204_L3.6mm_D1.6mm_P2.54mm_Vertical
R8: 3.92Meg; R_Axial_DIN0204_L3.6mm_D1.6mm_P2.54mm_Vertical
R9, R36: 6.8k; R_Axial_DIN0204_L3.6mm_D1.6mm_P2.54mm_Vertical
R10: 4.7Meg; R_Axial_DIN0204_L3.6mm_D1.6mm_P2.54mm_Vertical
R12, R13, R67, R68, R78, R79, R95, R96, R110, R111: 220; R_Axial_DIN0204_L3.6mm_D1.6mm_P2.54mm_Vertical
R14, R129, R130: 4.7k; R_Axial_DIN0204_L3.6mm_D1.6mm_P2.54mm_Vertical
R15, R17, R24, R25, R45, R47, R64, R65, R104, R118: 1k; R_Axial_DIN0204_L3.6mm_D1.6mm_P2.54mm_Vertical
R16, R18: 470; R_Axial_DIN0204_L3.6mm_D1.6mm_P2.54mm_Vertical
R19, R48: 47k; R_Axial_DIN0204_L3.6mm_D1.6mm_P2.54mm_Vertical
R20, R74, R103: 30k; R_Axial_DIN0204_L3.6mm_D1.6mm_P2.54mm_Vertical
R22, R60: 5.1k; R_Axial_DIN0204_L3.6mm_D1.6mm_P2.54mm_Vertical
R23, R38, R52, R55, R56, R57, R59, R61, R62, R63, R72, R84, R88, R89, R90, R91, R92, R93, R101, R105, R107, R114: 10k; R_Axial_DIN0204_L3.6mm_D1.6mm_P2.54mm_Vertical
R26: 442k; R_Axial_DIN0204_L3.6mm_D1.6mm_P2.54mm_Vertical
R27, R28: 220k; R_Axial_DIN0204_L3.6mm_D1.6mm_P2.54mm_Vertical
R29: 3.3Meg; R_Axial_DIN0204_L3.6mm_D1.6mm_P2.54mm_Vertical
R30, R71, R73, R75, R76, R83, R85, R94, R98, R100, R102, R109, R113, R115, R117, R131: 100k; R_Axial_DIN0204_L3.6mm_D1.6mm_P2.54mm_Vertical
R35: 1.5Meg; R_Axial_DIN0204_L3.6mm_D1.6mm_P2.54mm_Vertical
R37: 1Meg; R_Axial_DIN0204_L3.6mm_D1.6mm_P2.54mm_Vertical
R39: 22k; R_Axial_DIN0204_L3.6mm_D1.6mm_P2.54mm_Vertical
R40, R42: 18k; R_Axial_DIN0204_L3.6mm_D1.6mm_P2.54mm_Vertical
R49, R66, R77: 68k; R_Axial_DIN0204_L3.6mm_D1.6mm_P2.54mm_Vertical
R51: 4.3k; R_Axial_DIN0204_L3.6mm_D1.6mm_P2.54mm_Vertical
R53: 91k; R_Axial_DIN0204_L3.6mm_D1.6mm_P2.54mm_Vertical
R54: 39k; R_Axial_DIN0204_L3.6mm_D1.6mm_P2.54mm_Vertical
R58: 20k; R_Axial_DIN0204_L3.6mm_D1.6mm_P2.54mm_Vertical
R69, R80, R99: 200k; R_Axial_DIN0204_L3.6mm_D1.6mm_P2.54mm_Vertical
R70, R81: 330k; R_Axial_DIN0204_L3.6mm_D1.6mm_P2.54mm_Vertical
R82: 680k; R_Axial_DIN0204_L3.6mm_D1.6mm_P2.54mm_Vertical
R86, R133: 470k; R_Axial_DIN0204_L3.6mm_D1.6mm_P2.54mm_Vertical
R87: 25.5k; R_Axial_DIN0204_L3.6mm_D1.6mm_P2.54mm_Vertical
R97: 240k; R_Axial_DIN0204_L3.6mm_D1.6mm_P2.54mm_Vertical
R106, R108: 4.99k; R_Axial_DIN0204_L3.6mm_D1.6mm_P2.54mm_Vertical
R112: 143k; R_Axial_DIN0204_L3.6mm_D1.6mm_P2.54mm_Vertical
R116: 34k; R_Axial_DIN0204_L3.6mm_D1.6mm_P2.54mm_Vertical
R132: 42.2k; R_Axial_DIN0204_L3.6mm_D1.6mm_P2.54mm_Vertical
RV4: 20k; Potentiometer_Bourns_3296W_Vertical
RV5: 10k; Potentiometer_Bourns_3296W_Vertical
RV11: 100k; Potentiometer_Bourns_3296W_Vertical
U1: THAT320P14-U; DIP-14_W7.62mm_Socket
U2: LM319N/NOPB; DIP-14_W7.62mm_Socket
U3, U10, U13: LM13700N/NOPB; DIP-16_W7.62mm_Socket
U4, U6: CD4053BE; DIP-16_W7.62mm_Socket
U5, U7, U8, U9, U11, U12, U14, U15, U16: TL074; DIP-14_W7.62mm_Socket

Connections:
/+12V: C1.1, C3.1, C6.1, C8.1, C10.1, C12.1, C17.1, C19.1, C23.1, C26.1, C28.1, C30.1, C36.1, C38.1, C44.1, C46.1, C48.1, J20.2, J21.2, R1.2, R15.1, R21.1, R27.1, R39.1, R44.1, R50.1, R53.1, R82.1, R97.1, RV11.1, U2.11 (V+), U3.11 (V+), U4.16 (VDD), U5.4 (V+), U6.16 (VDD), U7.4 (V+), U8.4 (V+), U9.4 (V+), U10.11 (V+), U11.4 (V+), U12.4 (V+), U13.11 (V+), U14.4 (V+), U15.4 (V+), U16.4 (V+)
/+12V_D: D1.1 (K), R1.1
/+12V_IN: D1.2 (A), J1.9, J1.10
/-12V: C2.2, C4.1, C7.1, C9.1, C13.1, C20.1, C24.1, C27.1, C29.1, C31.1, C37.1, C39.1, C45.1, C47.1, C49.1, J20.3, J21.3, R2.1, R3.1, R8.2, R17.1, R28.1, R35.2, R38.2, R46.1, RV11.3, U2.6 (V-), U3.6 (V-), U5.11 (V-), U7.11 (V-), U8.11 (V-), U9.11 (V-), U10.6 (V-), U11.11 (V-), U12.11 (V-), U13.6 (V-), U14.11 (V-), U15.11 (V-), U16.11 (V-)
/-12V_D: D2.2 (A), R2.2
/-12V_IN: D2.1 (K), J1.1, J1.2
/AM_CV_J: J20.8, R99.1
/AM_IABC: Q3.1 (C), U13.1
/AM_IN: R94.2, R95.1, U13.3 (+)
/AM_INM: R96.1, U13.4 (-)
/AM_IV: C41.1, R103.1, U12.2 (-), U13.5
/AM_W: J20.4, U15.3 (+)
/F1_CL: D15.2 (A), D16.1 (K), R88.2, U9.10 (+)
/F1_N: R89.2, R90.1, U9.9 (-)
/F1_OUT: R90.2, R91.1, R92.1, U9.8
/F2_CL: D17.2 (A), D20.1 (K), R91.2, U9.12 (+)
/F2_D1: D17.1 (K), D18.2 (A)
/F2_D2: D19.1 (K), D20.2 (A)
/F2_N: R92.2, R93.1, U9.13 (-)
/F2_OUT: R93.2, R94.1, U9.14, U14.12 (+)
/FMI_CV_J: J20.29, R70.1
/FMI_W: J20.22, R69.1
/FM_EXP: J21.8, R32.1, R75.1
/FM_IABC: Q1.1 (C), U10.1
/FM_IN: R66.2, R67.1, U10.3 (+)
/FM_INM: R68.1, U10.4 (-)
/FM_IV: C33.1, R74.1, U9.2 (-), U10.5
/FM_LIN: J20.27, R54.1, R76.1
/FM_MOD: C33.2, J21.1, R74.2, U9.1
/GND: C1.2, C2.1, C3.2, C4.2, C5.1, C6.2, C7.2, C8.2, C9.2, C10.2, C11.2, C12.2, C13.2, C16.2, C17.2, C18.2, C19.2, C20.2, C23.2, C24.2, C25.2, C26.2, C27.2, C28.2, C29.2, C30.2, C31.2, C36.2, C37.2, C38.2, C39.2, C44.2, C45.2, C46.2, C47.2, C48.2, C49.2, D3.1 (K), D15.1 (K), D16.2 (A), D18.1 (K), D19.2 (A), D24.2 (A), D26.2 (A), D28.2 (A), D30.2 (A), D32.2 (A), D34.2 (A), D36.2 (A), D38.2 (A), D42.2 (A), J1.3, J1.4, J1.5, J1.6, J1.7, J1.8, J20.5, J20.10, J20.15, J20.20, J20.25, J20.30, J21.5, J21.10, J21.15, J21.20, J21.25, J21.29, J21.30, R12.2, R13.2, R16.2, R18.2, R23.2, R41.2, R42.2, R43.2, R45.2, R47.2, R52.2, R62.2, R63.2, R67.2, R68.2, R71.2, R72.2, R75.2, R76.2, R78.2, R79.2, R83.2, R84.2, R95.2, R96.2, R100.2, R101.2, R106.2, R110.2, R111.2, R113.2, R114.2, RV5.3, U1.2 (Q1_B), U1.4 (SUB), U1.6 (Q3_B), U1.11 (SUB), U2.3 (GND), U2.5 (-), U2.8 (GND), U2.10 (-), U3.7, U4.1 (Y1), U4.2 (Y0), U4.3 (Z1), U4.5 (Z0), U4.6 (Inh), U4.8 (VSS), U4.9 (C), U4.10 (B), U5.3 (+), U5.5 (+), U6.6 (Inh), U6.8 (VSS), U7.3 (+), U7.5 (+), U8.3 (+), U8.5 (+), U8.10 (+), U8.13 (-), U9.3 (+), U9.5 (+), U10.7, U10.10, U11.3 (+), U11.5 (+), U11.10 (+), U11.12 (+), U12.3 (+), U12.5 (+), U12.12 (+), U13.7, U13.10, U16.5 (+), U16.12 (+)
/LD1: R119.1, U14.1, U14.2 (-)
/LD1_A: D24.1 (K), J20.7, R119.2
/LD2: R107.1, R117.1, U14.6 (-), U14.7
/LD3: R120.1, U14.8, U14.9 (-)
/LD3_A: D26.1 (K), J21.28, R120.2
/LD4: R121.1, U14.13 (-), U14.14
/LD4_A: D28.1 (K), J21.21, R121.2
/LD5: R98.1, R122.1, U15.1, U15.2 (-)
/LD5_A: D30.1 (K), J20.11, R122.2
/LD6: R123.1, U15.6 (-), U15.7
/LD6_A: D32.1 (K), J20.14, R123.2
/LD7: R124.1, U15.8, U15.9 (-)
/LD7_A: D34.1 (K), J20.18, R124.2
/LD8: R125.1, U15.13 (-), U15.14
/LD8_A: D36.1 (K), J21.17, R125.2
/LD9: R126.1, U16.1, U16.2 (-)
/LD9_A: D38.1 (K), J21.13, R126.2
/LD11: R128.1, U16.8, U16.9 (-)
/LD11_A: D42.1 (K), J21.7, R128.2
/MAIN: C41.2, R103.2, R104.1, U12.1, U16.10 (+)
/MAIN_J: J21.4, R104.2
/MODE_EXP: J21.9, R129.1
/MODE_EXP_A: J20.21, R129.2
/MODE_LIN: J20.28, R130.1
/MODE_LIN_A: J21.11, R130.2
/M_BASE: R7.2, U1.13 (Q2_B)
/M_CAP: C16.1, U3.5, U5.12 (+)
/M_CK1: D4.1 (K), D5.2 (A)
/M_CK2: D6.1 (K), D7.2 (A)
/M_CRS_W: J20.12, R4.1
/M_CV_J: J20.9, R5.1
/M_E: R9.2, U1.3 (Q1_E), U1.12 (Q2_E)
/M_H: R19.2, R20.2, U2.4 (+)
/M_IABC: U1.14 (Q2_C), U3.1
/M_OM: R13.1, R14.2, U3.4 (-)
/M_OP: R12.1, U3.3 (+)
/M_REF: C15.1, R8.1, U1.1 (Q1_C), U5.6 (-)
/M_REFO: C15.2, R9.1, R10.1, U5.7
/M_S: R21.2, U2.12, U4.11 (A)
/M_SQN: R22.2, R23.1, U5.9 (-)
/M_SQRO: R22.1, R25.1, U5.8, U15.10 (+)
/M_SQR_J: J20.17, R25.2
/M_SUM: C14.1, D4.2 (A), D7.1 (K), R4.2, R5.2, R6.1, R10.2, U5.2 (-)
/M_SUMOUT: C14.2, D5.1 (K), D6.2 (A), R6.2, R7.1, U5.1
/M_TRI: J20.6, R19.1, R24.1, R66.1, U5.13 (-), U5.14, U14.3 (+), U15.5 (+)
/M_TRI_J: J20.13, R24.2
/M_VRN: R17.2, R18.1, U4.12 (X0)
/M_VRP: R15.2, R16.1, U4.13 (X1)
/M_VSW: R14.1, R20.1, U4.14 (X), U5.10 (+)
/P_BASE: R34.2, U1.9 (Q4_B)
/P_BIAS: R39.2, U3.15 (DIODE_BIAS)
/P_CAP: C25.1, U3.10, U3.12
/P_CK1: D8.1 (K), D9.2 (A)
/P_CK2: D10.1 (K), D11.2 (A)
/P_CRS_W: J21.18, R26.1
/P_CV_J: J21.19, R31.1
/P_E: R36.2, U1.5 (Q3_E), U1.10 (Q4_E)
/P_FH: J21.23, R27.2
/P_FINE_W: J21.24, R29.1
/P_FL: J21.26, R28.2
/P_H: R48.2, R49.2, U2.9 (+)
/P_HFW: R37.1, RV5.2
/P_IABC: U1.8 (Q4_C), U3.16
/P_NTH: R60.2, U6.2 (Y0)
/P_NTO: R59.2, R60.1, U8.8
/P_NX: R57.2, U6.13 (X1), U8.7
/P_NXN: R56.2, R57.1, U8.6 (-)
/P_OM: R42.1, R43.1, U3.13 (-)
/P_OP: R40.2, R41.1, U3.14 (+)
/P_REF: C22.1, R35.1, U1.7 (Q3_C), U7.6 (-)
/P_REFO: C22.2, R36.1, RV5.1, U7.7
/P_S: R50.2, U2.7, U6.9 (C), U6.11 (A)
/P_SG: D12.1 (K), R63.1, U6.10 (B)
/P_SGO: D12.2 (A), U8.14
/P_SQN: R51.2, R52.1, U7.9 (-)
/P_SQRO: J20.23, R51.1, R65.1, R105.1, U7.8, U16.3 (+)
/P_SQR_J: J21.12, R65.2
/P_SUM: C21.1, D8.2 (A), D11.1 (K), R26.2, R29.2, R31.2, R32.2, R33.1, R37.2, RV4.2, RV4.3, U7.2 (-)
/P_SUMOUT: C21.2, D9.1 (K), D10.2 (A), R33.2, R34.1, U7.1
/P_TH: R61.2, R62.1, U6.1 (Y1)
/P_TIN: R58.2, R59.1, U8.9 (-)
/P_TRI: J20.24, R58.1, R61.1, R64.1, R77.1, U7.13 (-), U7.14, U14.10 (+), U15.12 (+)
/P_TRIB: R38.1, U3.9, U7.12 (+)
/P_TRI_J: J21.16, R64.2
/P_TS: R48.1, U6.15 (Y)
/P_VOCT_J: J21.14, R30.1
/P_VRN: R46.2, R47.1, U6.5 (Z0)
/P_VRP: R44.2, R45.1, U6.3 (Z1)
/P_VSW: R49.1, U6.4 (Z), U7.10 (+)
/P_VT: R30.2, RV4.1
/P_X: R55.2, R56.1, U6.12 (X0), U8.1, U8.12 (+)
/P_XN: R53.2, R54.2, R55.1, U8.2 (-)
/P_XS: R40.1, U6.14 (X)
/SC_IN: R109.2, R110.1, U13.13 (-)
/SC_INP: R111.1, R133.2, U13.14 (+)
/SC_IV: C43.1, R116.1, U12.13 (-), U13.12
/SC_TRIM: R133.1, RV11.2
/SC_V: C43.2, R116.2, R132.1, U12.14
/SD_M: R107.2, R108.1, U12.9 (-)
/SD_OUT: R108.2, R109.1, U12.8
/SD_P: R105.2, R106.1, U12.10 (+)
/SH_CV_J: J21.6, R112.1
/SH_IABC: Q4.1 (C), U13.16
/SH_J: J20.16, R118.2
/SH_OUT: R118.1, R131.1, U12.7
/SH_SUM: R117.2, R131.2, R132.2, U12.6 (-)
/SH_W: J20.26, U14.5 (+)
/SYM_W: J20.1, R86.1
/TB_CV_J: J21.27, R81.1
/TB_DRV: C35.2, R87.2, R88.1, R89.1, U9.7
/TB_IABC: Q2.1 (C), U10.16
/TB_IN: R77.2, R78.1, U10.14 (+)
/TB_INM: R79.1, U10.13 (-)
/TB_IV: C35.1, R86.2, R87.1, U9.6 (-), U10.12
/TB_W: J21.22, R80.1
/U16B_TIE: U16.6 (-), U16.7
/U16D_TIE: U16.13 (-), U16.14
/VEE: C5.2, C11.1, C18.1, D3.2 (A), R3.2, U4.7 (VEE), U6.7 (VEE)
/VI1_B: D13.2 (A), Q1.2 (B), R71.1
/VI1_E: C32.1, Q1.3 (E), R72.1, R73.1
/VI1_N: C32.2, R69.2, R70.2, R73.2, U11.2 (-)
/VI1_O: D13.1 (K), U11.1
/VI2_B: D14.2 (A), Q2.2 (B), R83.1
/VI2_E: C34.1, Q2.3 (E), R84.1, R85.1
/VI2_N: C34.2, R80.2, R81.2, R82.2, R85.2, U11.6 (-)
/VI2_O: D14.1 (K), U11.7
/VI3_B: D21.2 (A), Q3.2 (B), R100.1
/VI3_E: C40.1, Q3.3 (E), R101.1, R102.1
/VI3_N: C40.2, R97.2, R98.2, R99.2, R102.2, U11.9 (-)
/VI3_O: D21.1 (K), U11.8
/VI4_B: D22.2 (A), Q4.2 (B), R113.1
/VI4_E: C42.1, Q4.3 (E), R114.1, R115.1
/VI4_N: C42.2, D45.1 (K), R112.2, R115.2, U11.13 (-)
/VI4_O: D22.1 (K), D45.2 (A), U11.14

Notes on the sheet:
POWER: Eurorack 10-pin, reverse protection, decoupling
MODULATION OSCILLATOR (THAT320 expo + tempco, LM13700 core, LM319/CD4053 switching)
PRINCIPAL OSCILLATOR (1V/oct, HF comp, through-zero linear FM core)
FM INDEX VCA + LIN/EXP
TIMBRE: VCA drive + symmetry + 2-stage diode wavefolder
AM VCA (+AM CV), SHAPE morph (+SHAPE CV OTA), outputs
LED DRIVERS: TL074 followers, 2.2k limit, 1N4148 reverse clamp

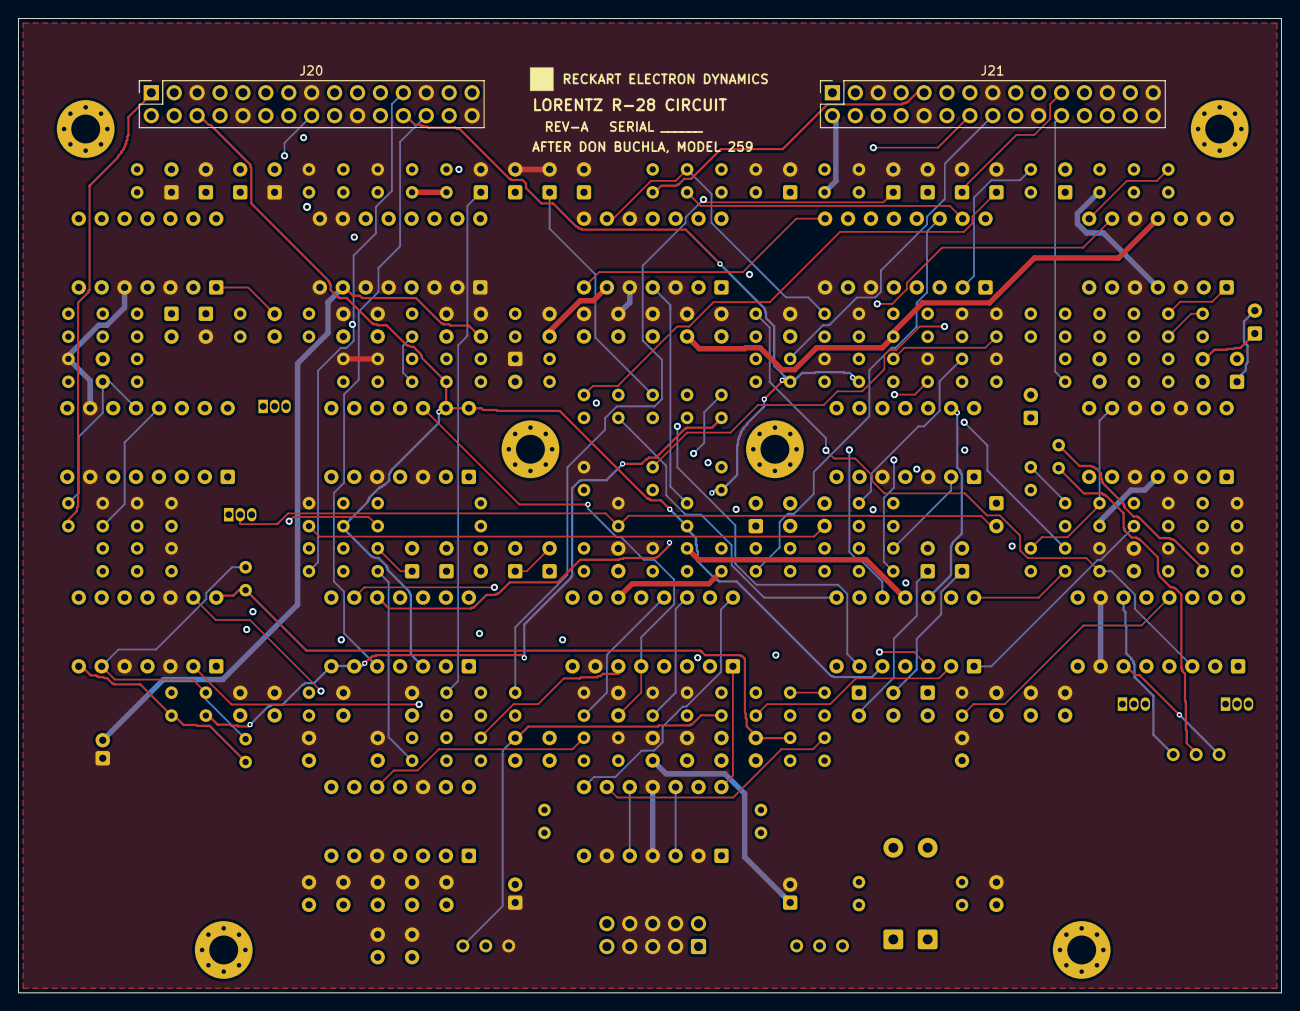
[picture p12: board VCO_CIRCUIT.kicad_pcb from above]

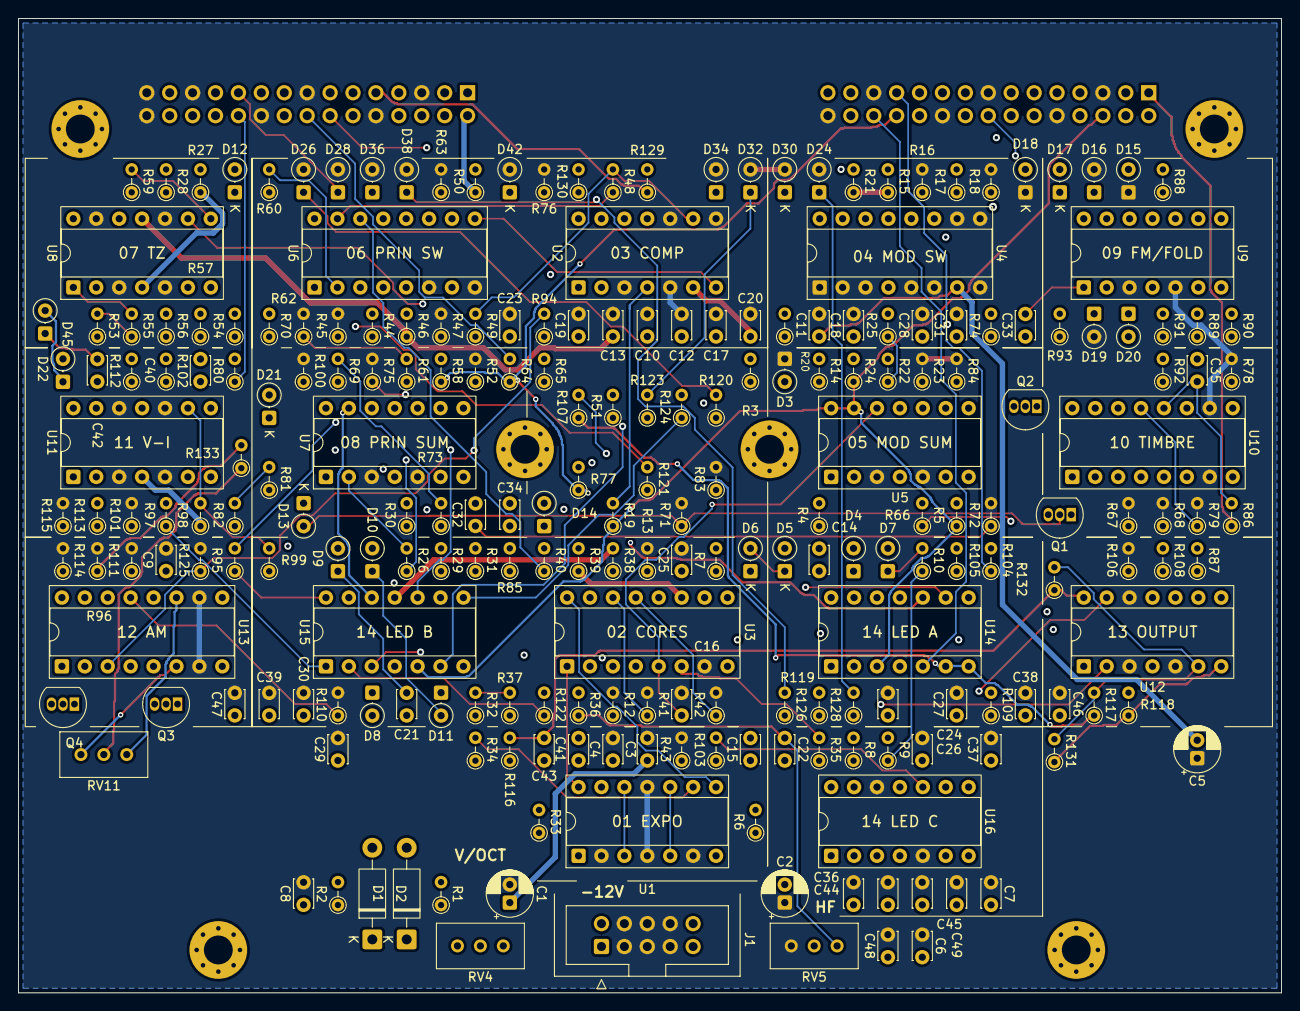
[picture p13: board VCO_CIRCUIT.kicad_pcb from below]

Board: 4 copper layers, 140.0 x 108.0 mm, 244 parts (236 on the bottom side), 164 nets.

Other parts of the board:
H1, H2, H3, H4, H5, H6: M3 standoff; MountingHole_3.2mm_M3_Pad_Via
