tylerreckart/lorentz/control_board/VCO_CONTROL.kicad_pcb

## KiCad design control_board/VCO_CONTROL.kicad_pcb (2026-11-02)

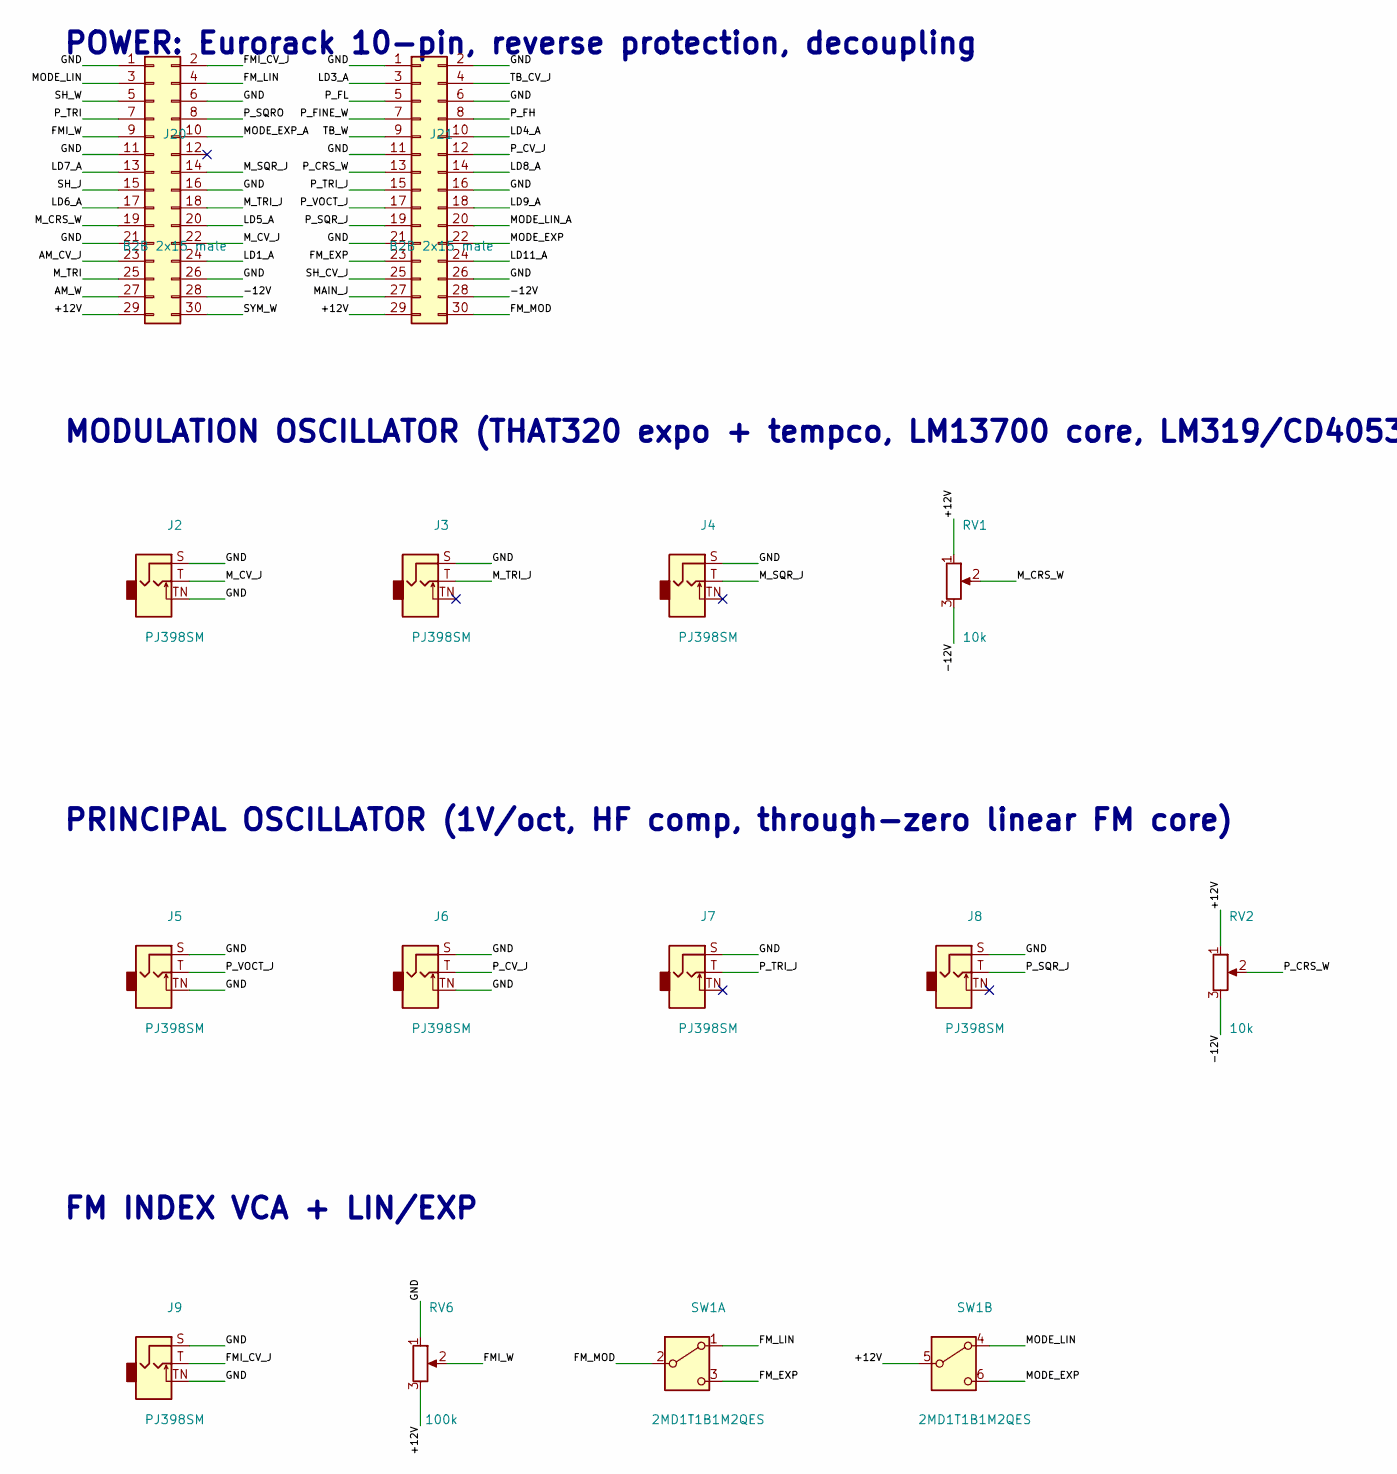
[picture p14: schematic VCO_CONTROL.kicad_sch, LORENTZ R-28 Complex Oscillator (after Buchla 259) - Eurora…, part in row 1, column 1]

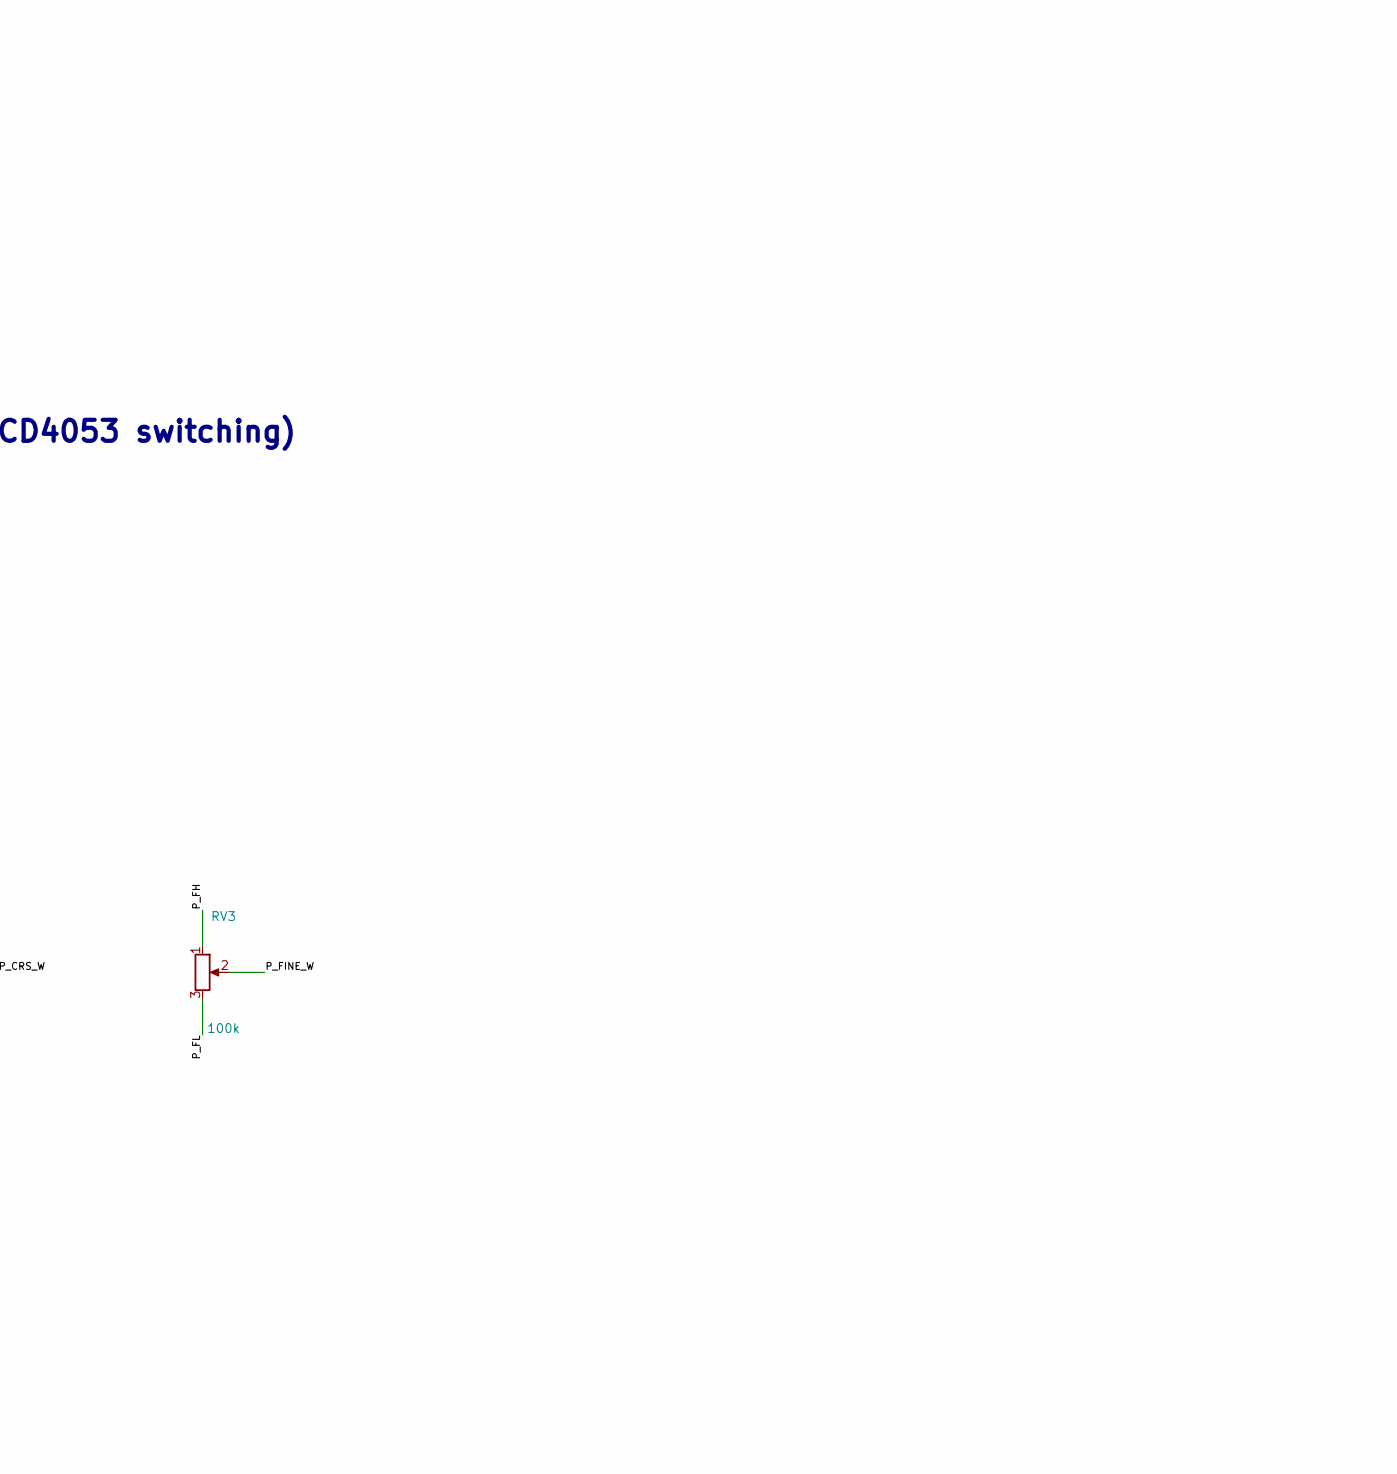
[picture p15: schematic VCO_CONTROL.kicad_sch, LORENTZ R-28 Complex Oscillator (after Buchla 259) - Eurora…, part in row 1, column 2]

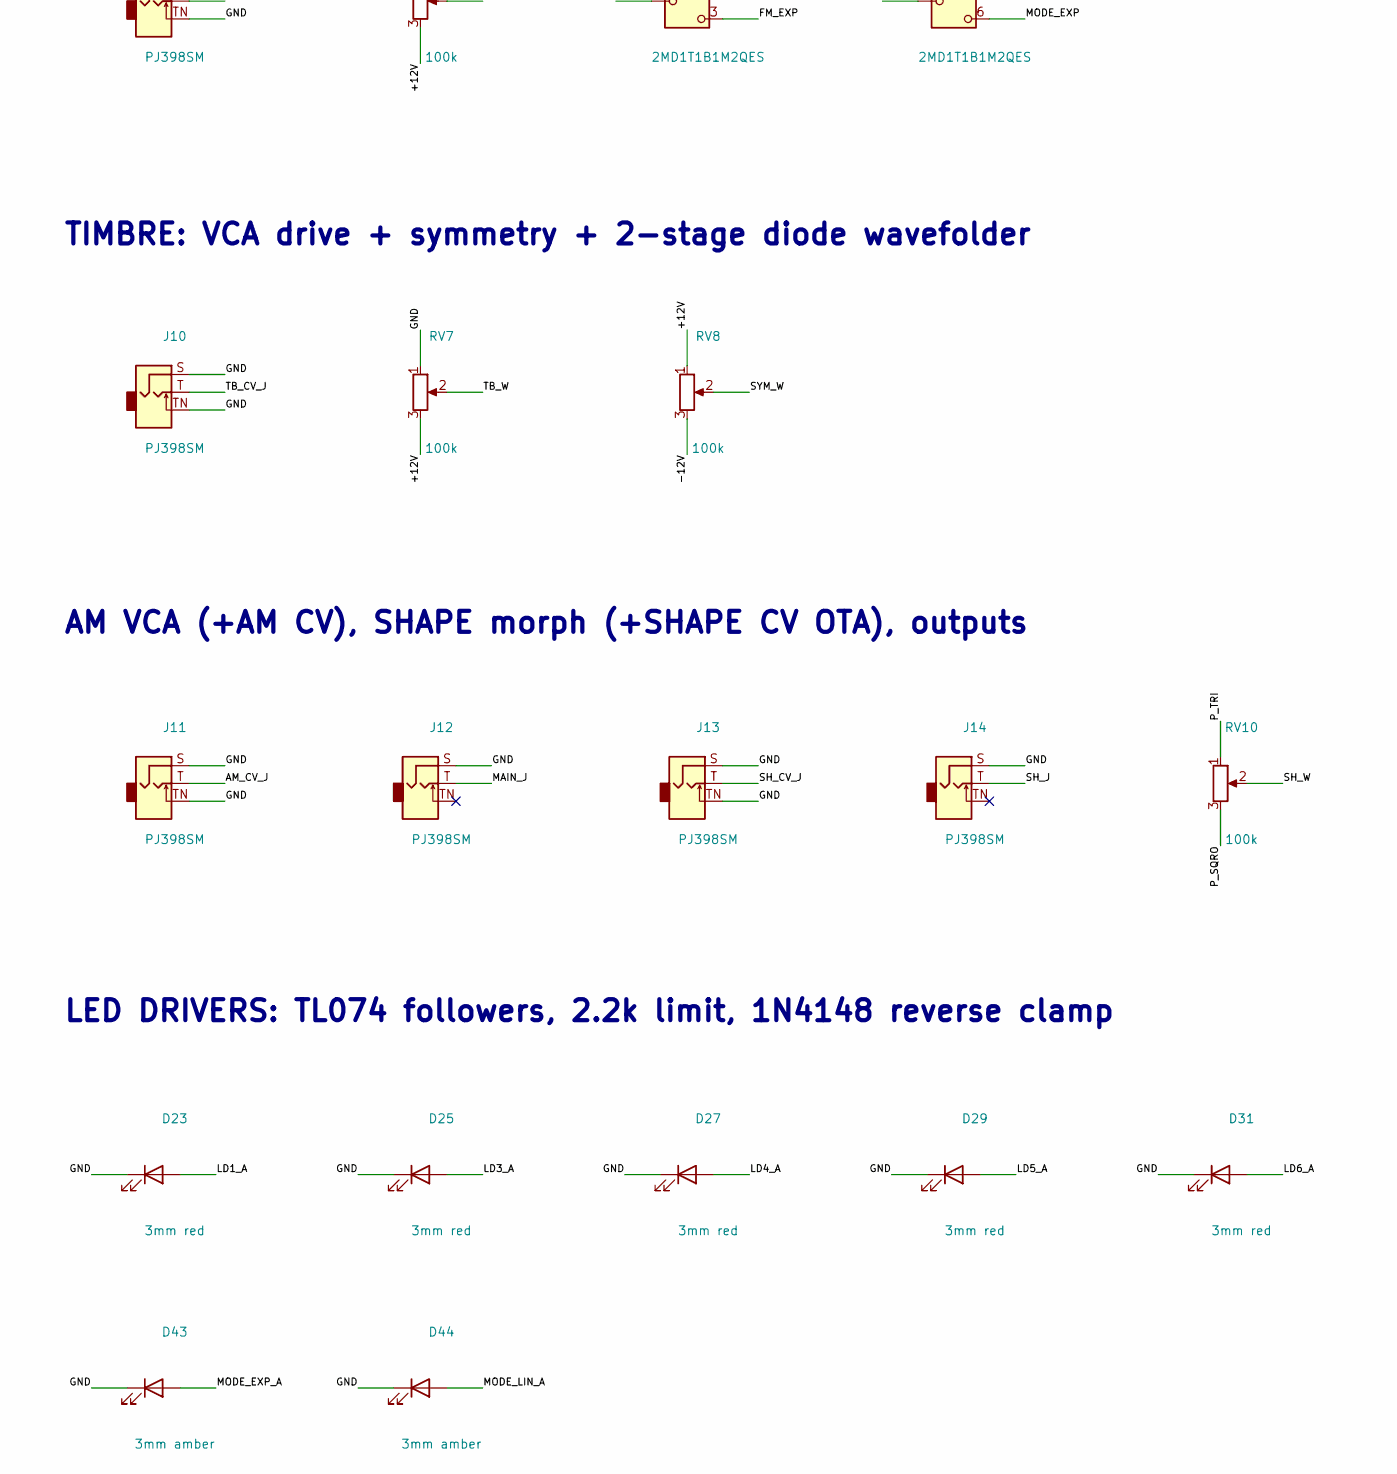
[picture p16: schematic VCO_CONTROL.kicad_sch, LORENTZ R-28 Complex Oscillator (after Buchla 259) - Eurora…, part in row 2, column 1]

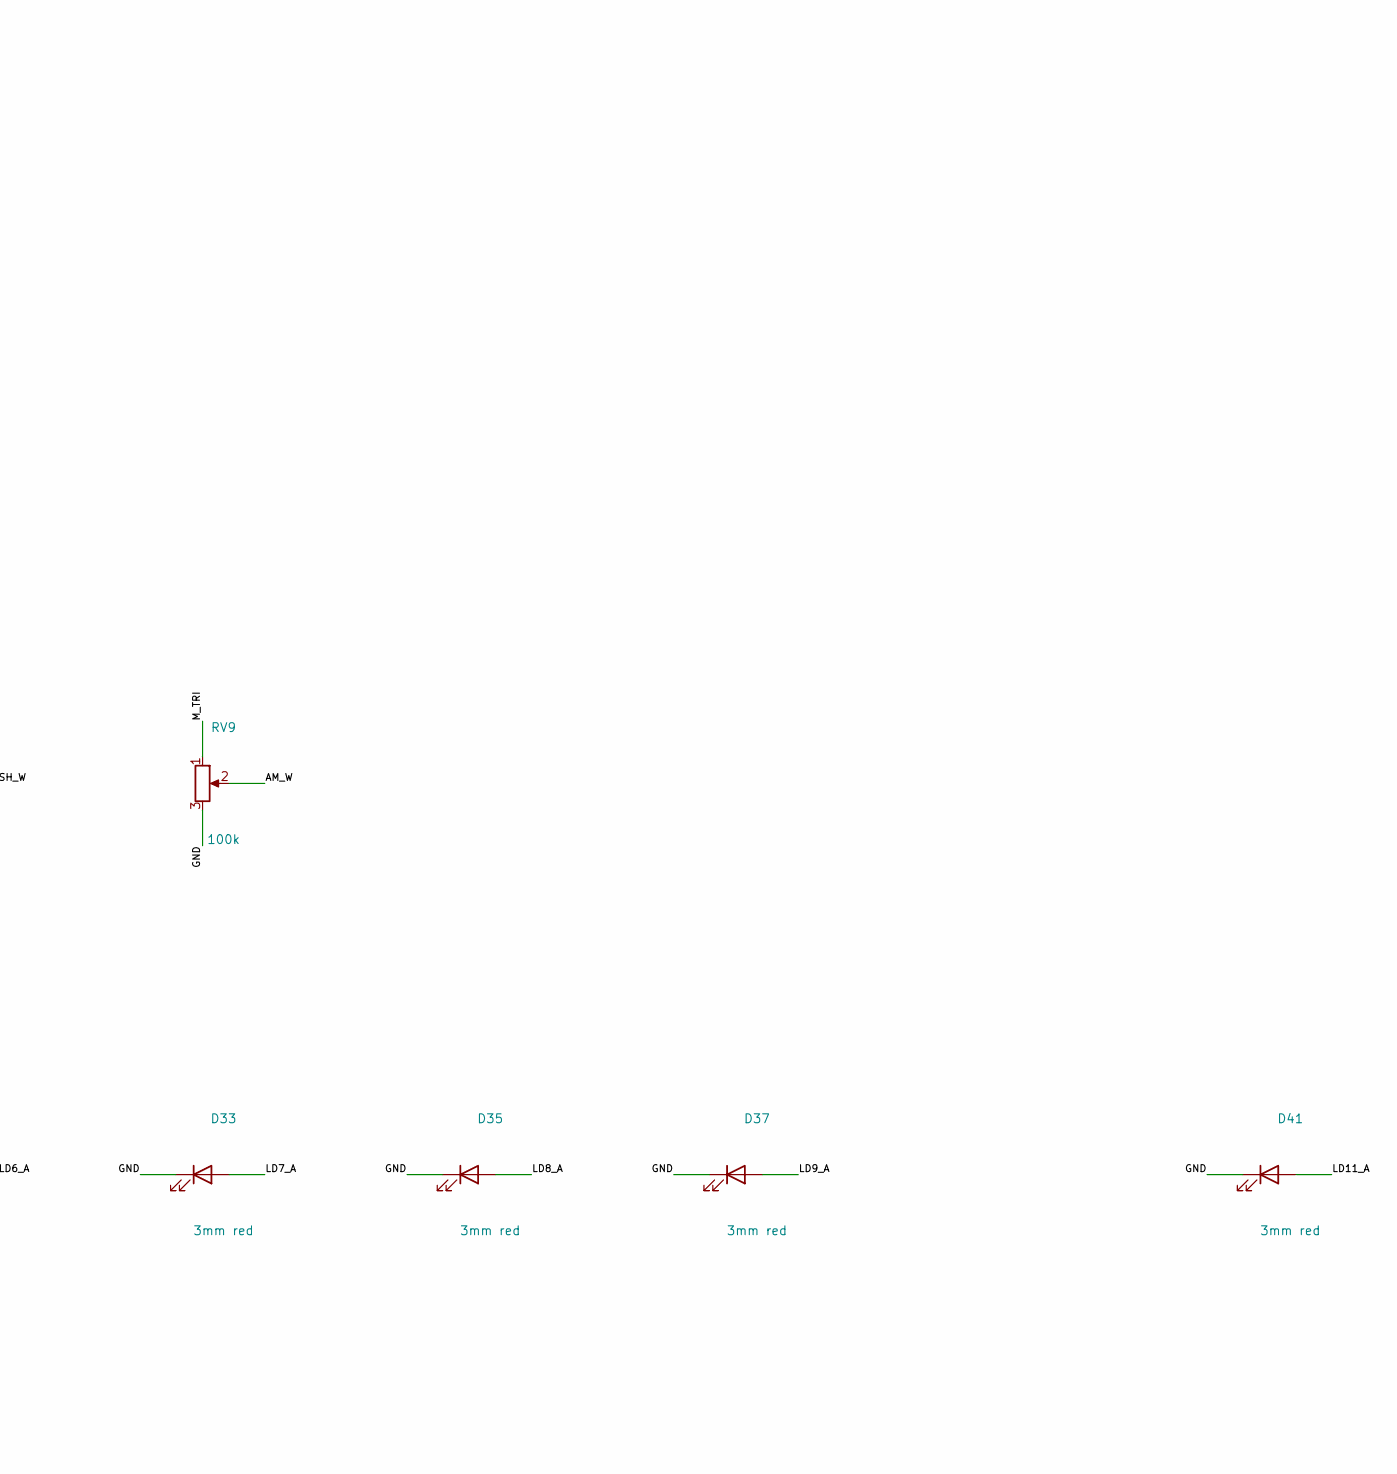
[picture p17: schematic VCO_CONTROL.kicad_sch, LORENTZ R-28 Complex Oscillator (after Buchla 259) - Eurora…, part in row 2, column 2]

Parts:
D23, D25, D27, D29, D31, D33, D35, D37, D41: 3mm red; LED_D3.0mm
D43, D44: 3mm amber; LED_D3.0mm
J2, J3, J4, J5, J6, J7, J8, J9, J10, J11, J12, J13, J14: PJ398SM; Jack_3.5mm_QingPu_WQP-PJ398SM_Vertical_CircularHoles
J20, J21: B2B 2x15 male; PinHeader_2x15_P2.54mm_Vertical
RV1, RV2: 10k; Alpha_RV16AF-41_Single_Vertical
RV3, RV6, RV7, RV8, RV9, RV10: 100k; Potentiometer_Alpha_RD901F-40-00D_Single_Vertical
SW1: 2MD1T1B1M2QES; SW_Dailywell_2MD1_M2

Connections:
/+12V: J20.29, J21.29, RV1.1, RV2.1, RV6.3, RV7.3, RV8.1, SW1.5 (B)
/-12V: J20.28, J21.28, RV1.3, RV2.3, RV8.3
/AM_CV_J: J11.T, J20.23
/AM_W: J20.27, RV9.2
/FMI_CV_J: J9.T, J20.2
/FMI_W: J20.9, RV6.2
/FM_EXP: J21.23, SW1.3 (C)
/FM_LIN: J20.4, SW1.1 (A)
/FM_MOD: J21.30, SW1.2 (B)
/GND: D23.1 (K), D25.1 (K), D27.1 (K), D29.1 (K), D31.1 (K), D33.1 (K), D35.1 (K), D37.1 (K), D41.1 (K), D43.1 (K), D44.1 (K), J2.S, J2.TN, J3.S, J4.S, J5.S, J5.TN, J6.S, J6.TN, J7.S, J8.S, J9.S, J9.TN, J10.S, J10.TN, J11.S, J11.TN, J12.S, J13.S, J13.TN, J14.S, J20.1, J20.6, J20.11, J20.16, J20.21, J20.26, J21.1, J21.2, J21.6, J21.11, J21.16, J21.21, J21.26, RV6.1, RV7.1, RV9.3
/LD1_A: D23.2 (A), J20.24
/LD3_A: D25.2 (A), J21.3
/LD4_A: D27.2 (A), J21.10
/LD5_A: D29.2 (A), J20.20
/LD6_A: D31.2 (A), J20.17
/LD7_A: D33.2 (A), J20.13
/LD8_A: D35.2 (A), J21.14
/LD9_A: D37.2 (A), J21.18
/LD11_A: D41.2 (A), J21.24
/MAIN_J: J12.T, J21.27
/MODE_EXP: J21.22, SW1.6 (C)
/MODE_EXP_A: D43.2 (A), J20.10
/MODE_LIN: J20.3, SW1.4 (A)
/MODE_LIN_A: D44.2 (A), J21.20
/M_CRS_W: J20.19, RV1.2
/M_CV_J: J2.T, J20.22
/M_SQR_J: J4.T, J20.14
/M_TRI: J20.25, RV9.1
/M_TRI_J: J3.T, J20.18
/P_CRS_W: J21.13, RV2.2
/P_CV_J: J6.T, J21.12
/P_FH: J21.8, RV3.1
/P_FINE_W: J21.7, RV3.2
/P_FL: J21.5, RV3.3
/P_SQRO: J20.8, RV10.3
/P_SQR_J: J8.T, J21.19
/P_TRI: J20.7, RV10.1
/P_TRI_J: J7.T, J21.15
/P_VOCT_J: J5.T, J21.17
/SH_CV_J: J13.T, J21.25
/SH_J: J14.T, J20.15
/SH_W: J20.5, RV10.2
/SYM_W: J20.30, RV8.2
/TB_CV_J: J10.T, J21.4
/TB_W: J21.9, RV7.2

Notes on the sheet:
POWER: Eurorack 10-pin, reverse protection, decoupling
MODULATION OSCILLATOR (THAT320 expo + tempco, LM13700 core, LM319/CD4053 switching)
PRINCIPAL OSCILLATOR (1V/oct, HF comp, through-zero linear FM core)
FM INDEX VCA + LIN/EXP
TIMBRE: VCA drive + symmetry + 2-stage diode wavefolder
AM VCA (+AM CV), SHAPE morph (+SHAPE CV OTA), outputs
LED DRIVERS: TL074 followers, 2.2k limit, 1N4148 reverse clamp

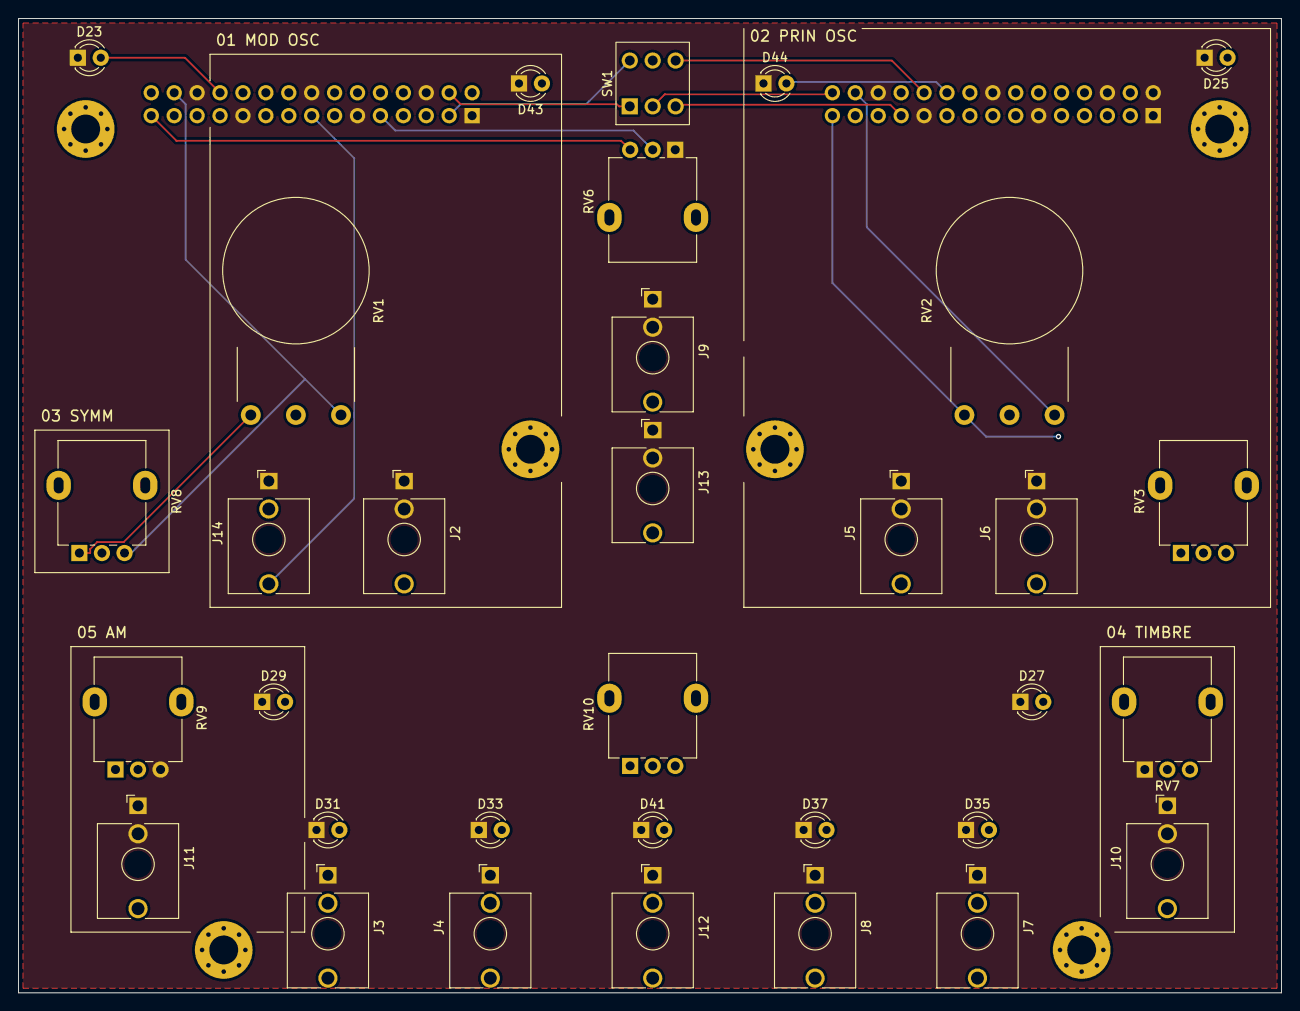
[picture p18: board VCO_CONTROL.kicad_pcb from above]

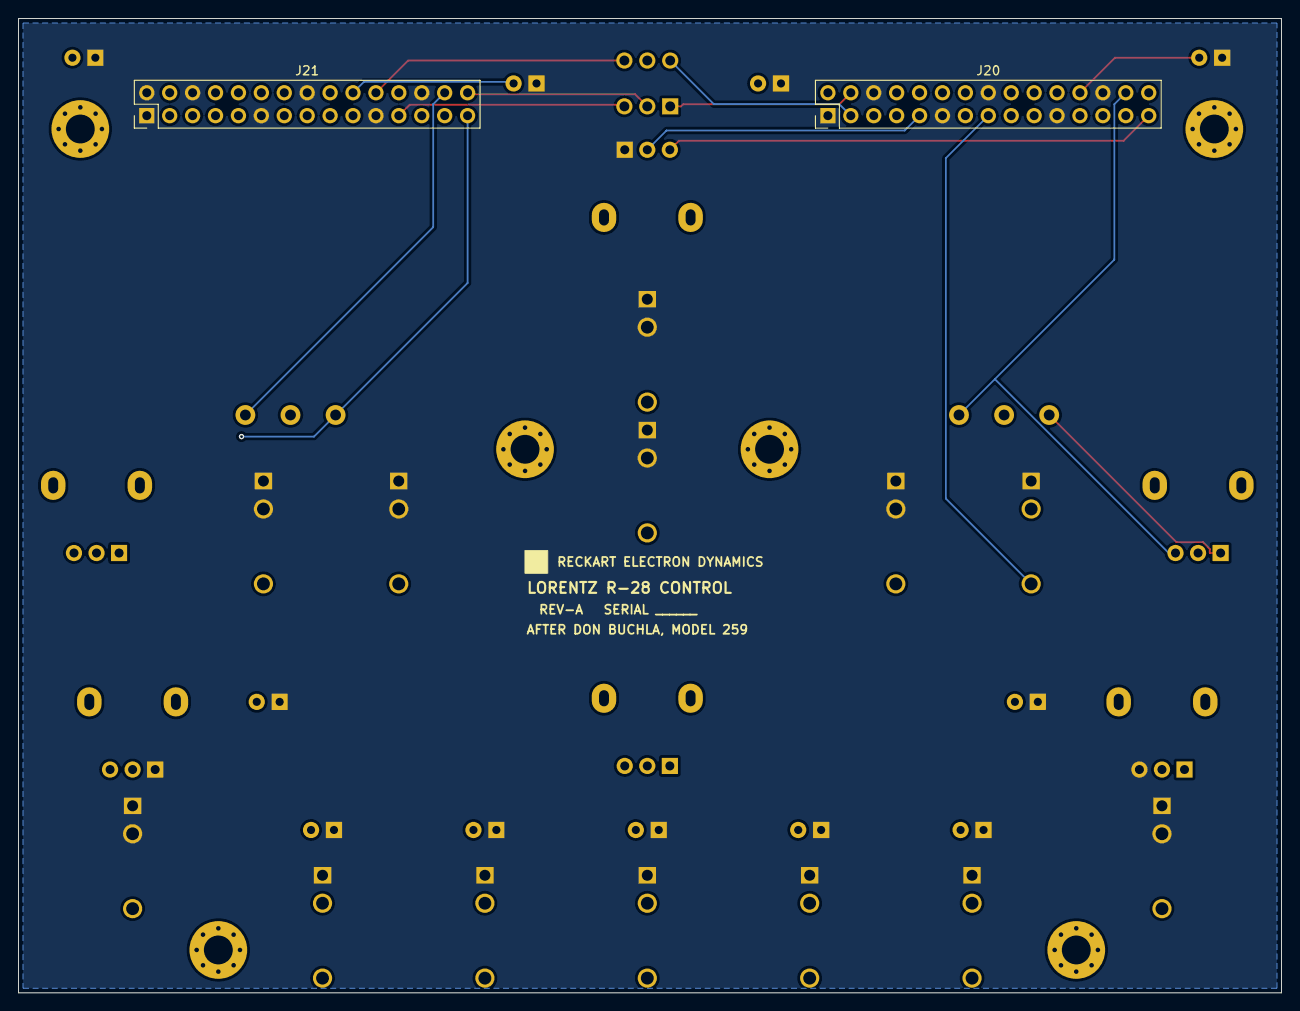
[picture p19: board VCO_CONTROL.kicad_pcb from below]

Board: 4 copper layers, 140.0 x 108.0 mm, 41 parts (2 on the bottom side), 45 nets.

Other parts of the board:
H1, H2, H3, H4, H5, H6: M3 standoff; MountingHole_3.2mm_M3_Pad_Via
