tylerreckart/lorentz/(commit log)

2026-11-01 initial commit. rev-a
    [LORENTZ_REV-A_BOM.csv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]
2026-11-02 tweak circuit
    [LORENTZ_REV-A_BOM.csv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]
